Diabltica/Desktopia/documentation/global-architecture.png

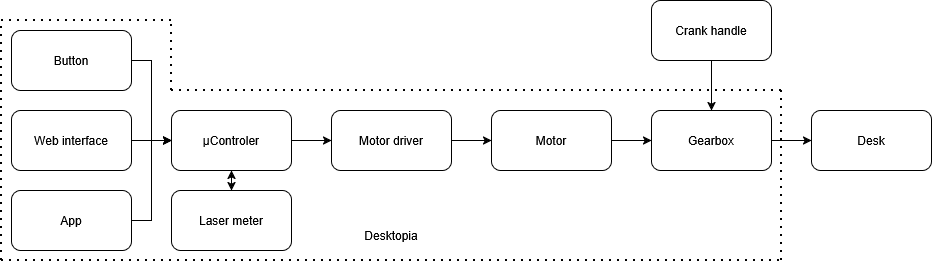
documentation/global-architecture.png
