Diabltica/Desktopia/mechanical/docs/clip_sample4_drawing.png

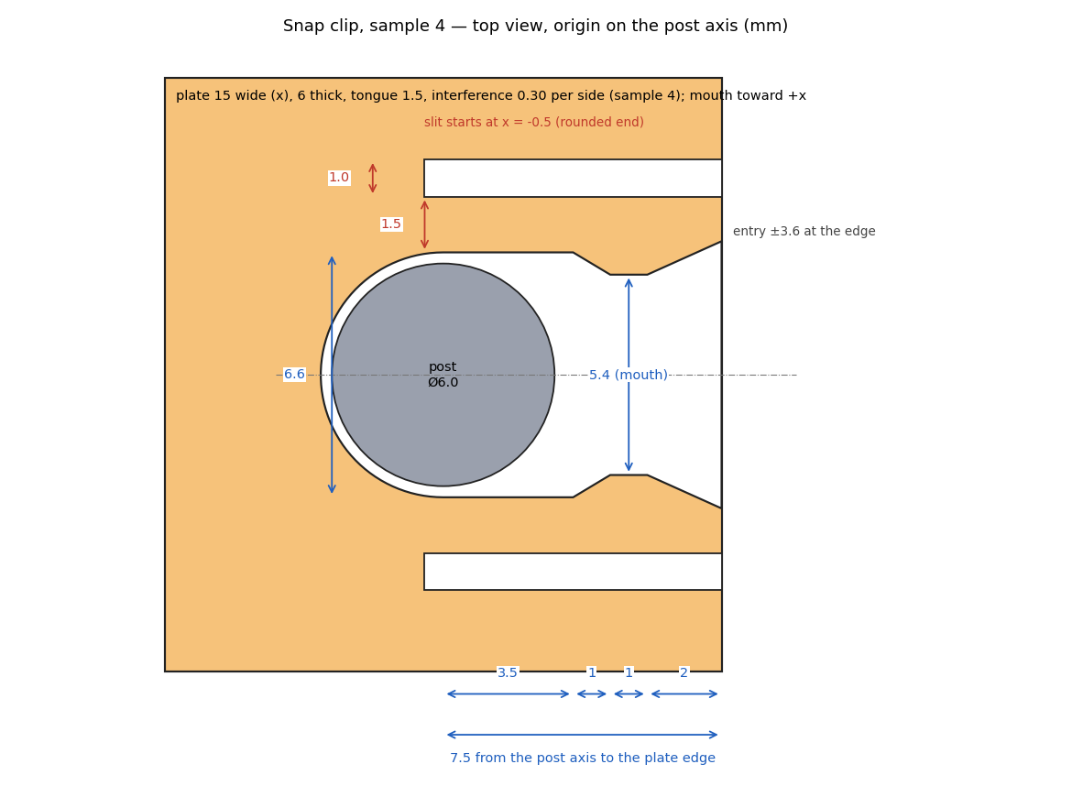
mechanical/docs/clip_sample4_drawing.png
