Diabltica/Desktopia/mechanical/step/assembly_coupler_on_hub_b.step

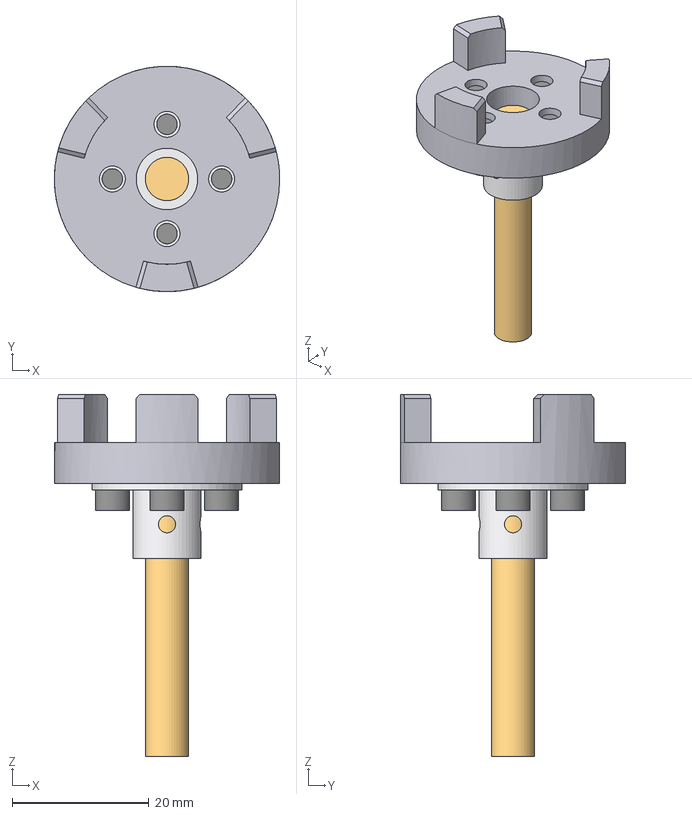
[picture p16: CAD file, 2026-11-08]
mechanical/step/assembly_coupler_on_hub_b.step
33.0 x 33.0 x 53.0 mm
hub_b_flange_side
flange_coupler
screws_M3x6
desk_shaft_6.35
