Diabltica/Desktopia/mechanical/step/assembly_coupler.step

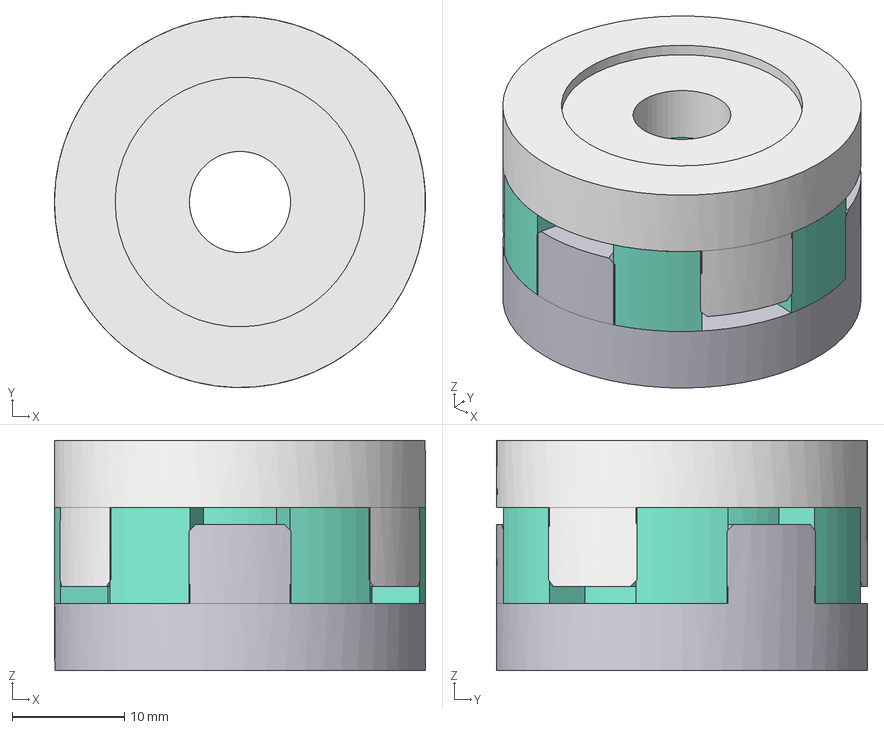
[picture p17: CAD file, 2026-11-08]
mechanical/step/assembly_coupler.step
33.0 x 33.0 x 20.5 mm
hub_b_flange_side
spider_tpu
hub_a_drill_side
