Diabltica/Desktopia/mechanical/step/assembly_check.step

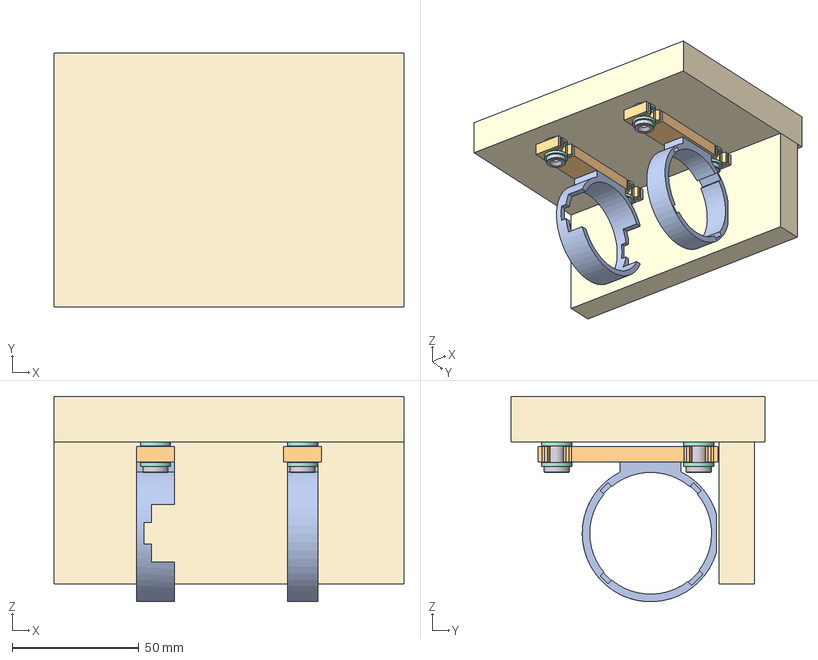
[picture p18: CAD file, 2026-11-08]
mechanical/step/assembly_check.step
138.0 x 100.0 x 81.0 mm
plank
vertical_wood
ring_support_motor_mount
clip_plate_motor_mount
plot_motor_mount_-37
cushion_top_motor_mount_-37
cushion_bottom_motor_mount_-37
plot_motor_mount_+19
cushion_top_motor_mount_+19
cushion_bottom_motor_mount_+19
ring_support_front_mount
clip_plate_front_mount
plot_front_mount_-37
cushion_top_front_mount_-37
cushion_bottom_front_mount_-37
plot_front_mount_+19
cushion_top_front_mount_+19
cushion_bottom_front_mount_+19
