Diabltica/Desktopia/hardware/kicad_library/pcb/EASYEDA_MODELS/SOP-8_L4.9-W3.9-P1.27-LS6.0-BL-1.step

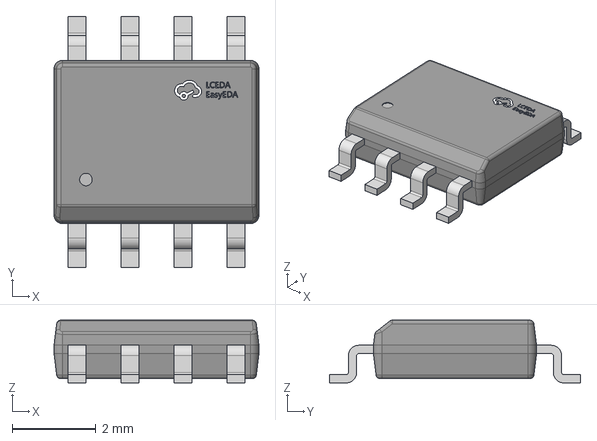
[picture p19: CAD file, 2026-08-25]
hardware/kicad_library/pcb/EASYEDA_MODELS/SOP-8_L4.9-W3.9-P1.27-LS6.0-BL-1.step
4.90 x 6.00 x 1.50 mm
