Diabltica/Desktopia/mechanical/stl/ring_support_front_mount_print.stl

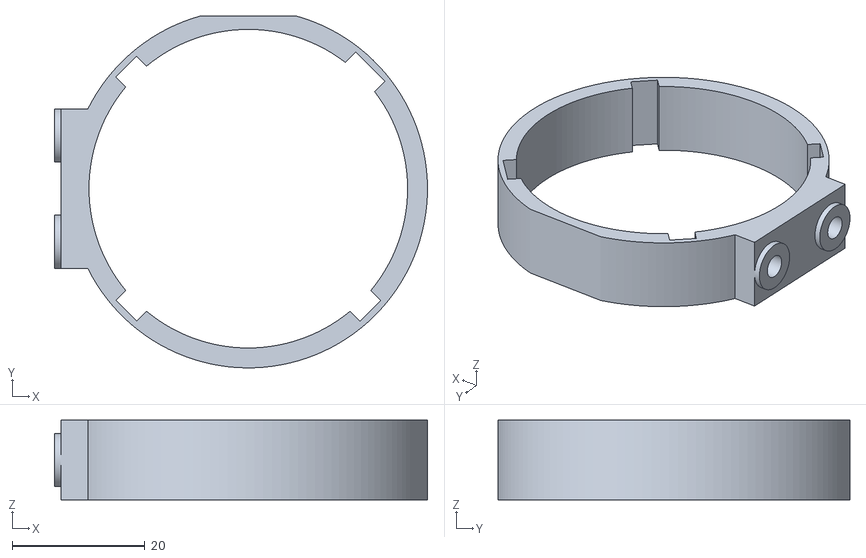
[picture p20: CAD file, 2026-11-08]
mechanical/stl/ring_support_front_mount_print.stl
56.2 x 53.0 x 12.0
