Diabltica/Desktopia/mechanical/solidworks/drillAdapterV4.SLDPRT

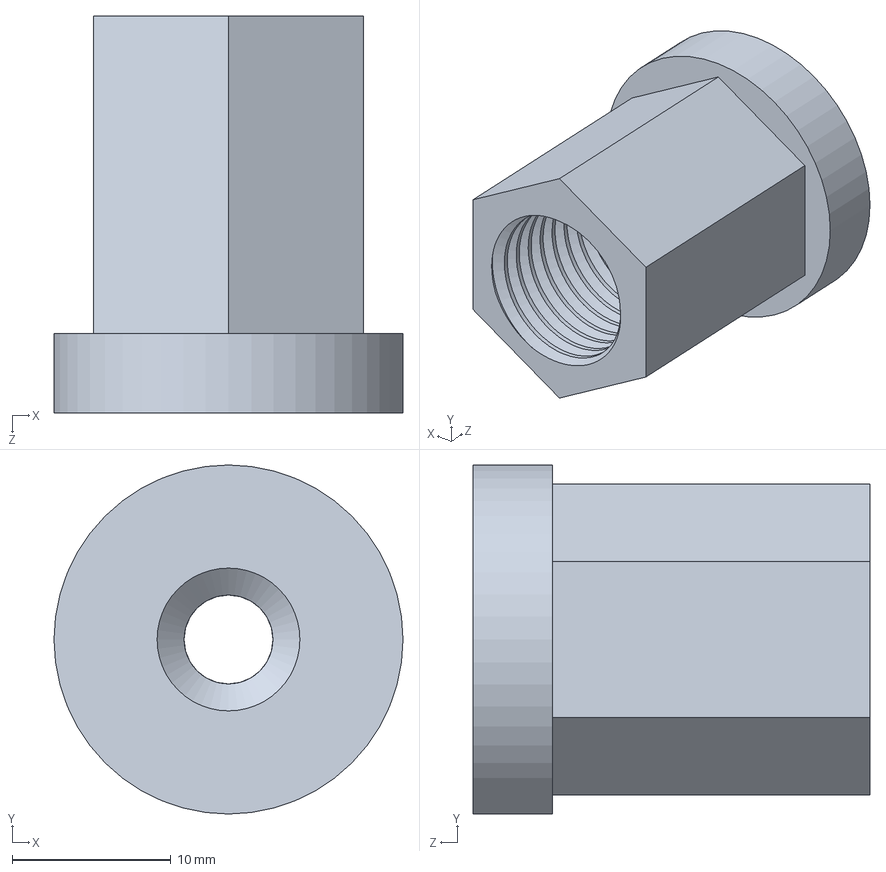
[picture p21: CAD file, 2026-11-03]
mechanical/solidworks/drillAdapterV4.SLDPRT
22.0 x 22.0 x 25.0 mm
