Diabltica/Desktopia/mechanical/stl/clip_plates_x2.stl

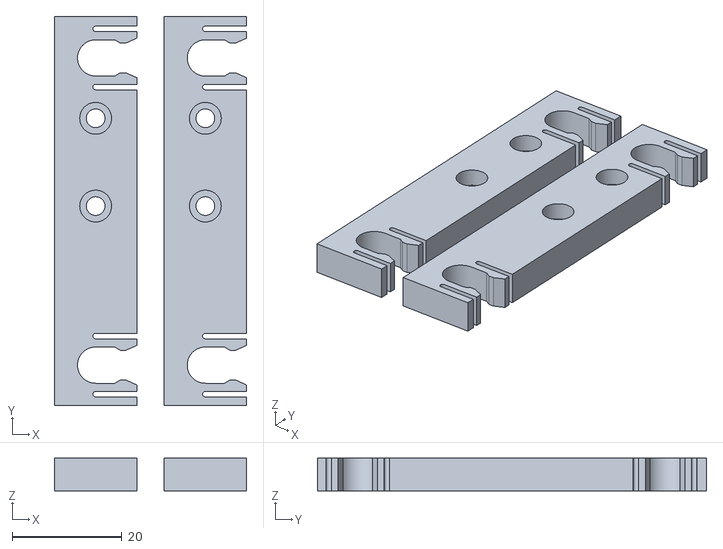
[picture p22: CAD file, 2026-11-08]
mechanical/stl/clip_plates_x2.stl
35.0 x 71.0 x 6.00
