Diabltica/Desktopia/mechanical/step/drill_jig.step

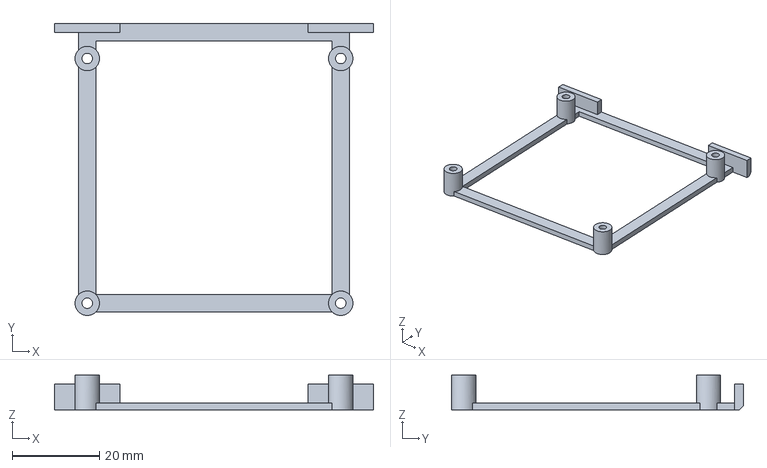
[picture p23: CAD file, 2026-11-08]
mechanical/step/drill_jig.step
73.0 x 66.8 x 8.00 mm
