Diabltica/Desktopia/mechanical/stl/ring_support_motor_mount_print.stl

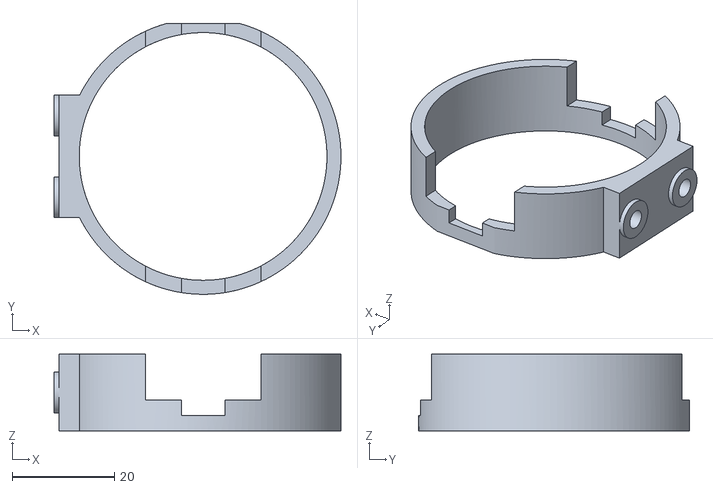
[picture p24: CAD file, 2026-11-08]
mechanical/stl/ring_support_motor_mount_print.stl
56.2 x 53.0 x 15.0
