Diabltica/Desktopia/mechanical/stl/cushions_x8.stl

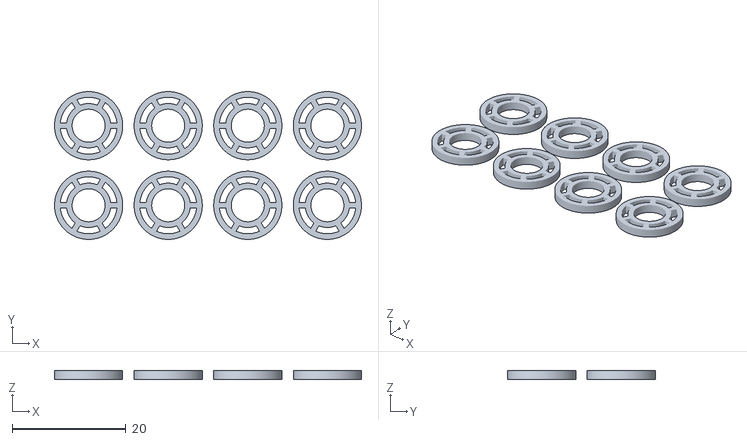
[picture p25: CAD file, 2026-11-02]
mechanical/stl/cushions_x8.stl
54.0 x 26.0 x 1.50
