Diabltica/Desktopia/mechanical/step/clip_plate_mirrored.step

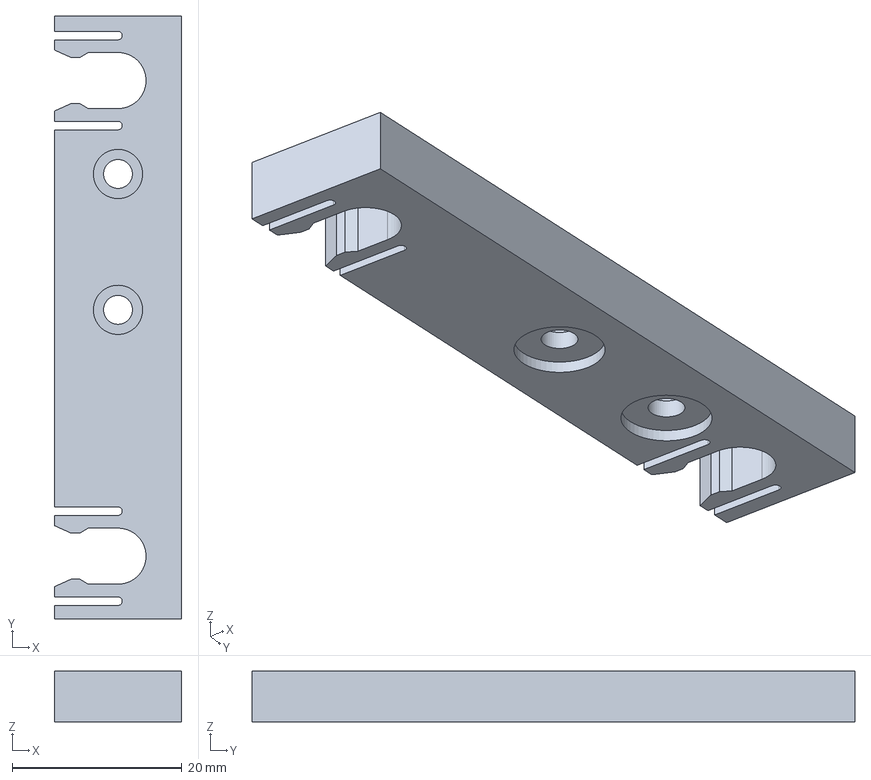
[picture p26: CAD file, 2026-11-08]
mechanical/step/clip_plate_mirrored.step
15.0 x 71.0 x 6.00 mm
