Diabltica/Desktopia/mechanical/stl/plots_x4.stl

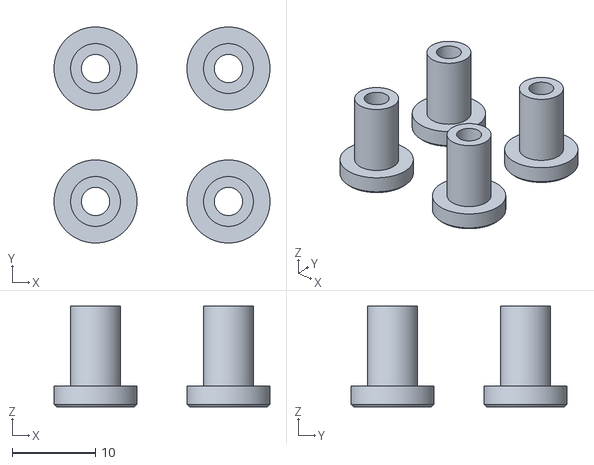
[picture p27: CAD file, 2026-11-02]
mechanical/stl/plots_x4.stl
26.0 x 26.0 x 12.1
