Diabltica/Desktopia/mechanical/step/hub_b_flange_side.step

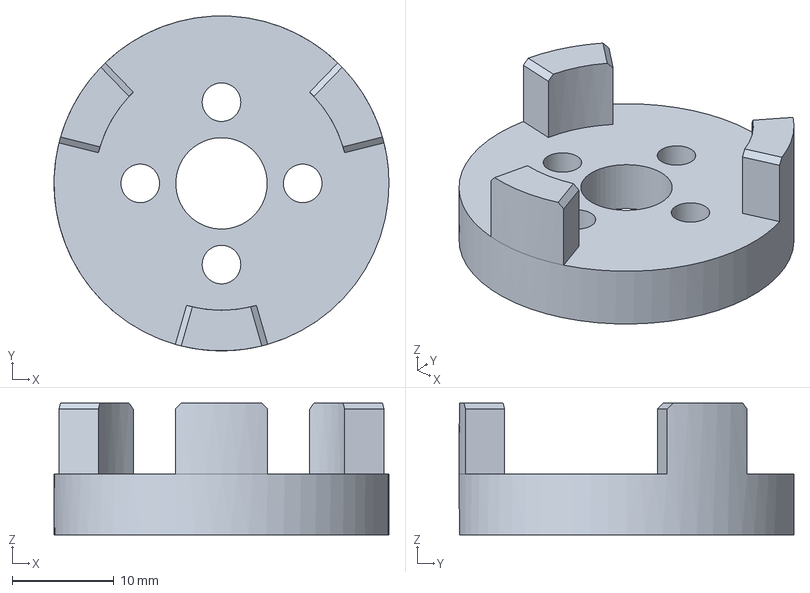
[picture p28: CAD file, 2026-11-08]
mechanical/step/hub_b_flange_side.step
33.0 x 33.0 x 13.0 mm
