Diabltica/Desktopia/mechanical/step/clip_cut_tool.step

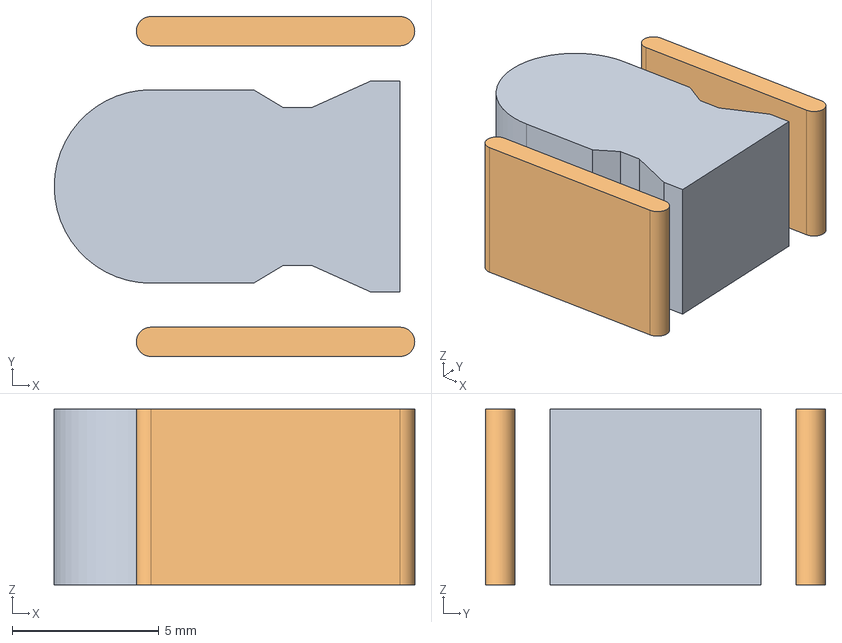
[picture p29: CAD file, 2026-11-02]
mechanical/step/clip_cut_tool.step
12.3 x 11.6 x 6.00 mm
