Diabltica/Desktopia/mechanical/step/clip_sample4_profile.dxf

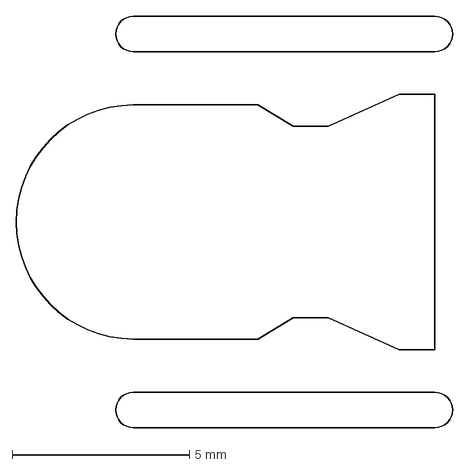
[picture p30: CAD file, 2026-11-02]
mechanical/step/clip_sample4_profile.dxf
12.3 x 11.6 mm
