Diabltica/Desktopia/mechanical/step/cushion_solid.step

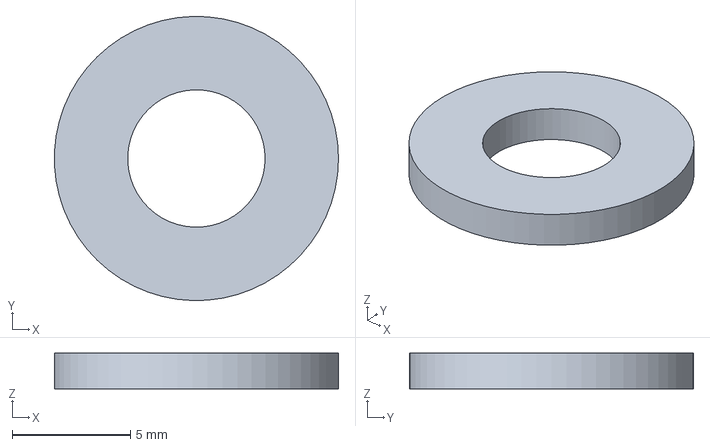
[picture p31: CAD file, 2026-11-02]
mechanical/step/cushion_solid.step
12.0 x 12.0 x 1.50 mm
