Diabltica/Desktopia/mechanical/step/cushion_wheel.step

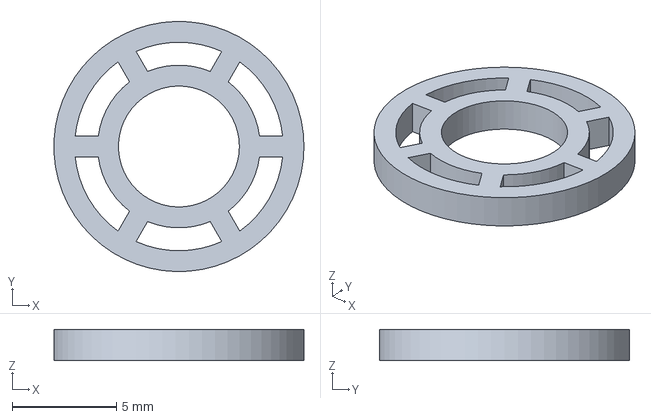
[picture p32: CAD file, 2026-11-02]
mechanical/step/cushion_wheel.step
12.0 x 12.0 x 1.50 mm
