Diabltica/Desktopia/mechanical/step/flange_coupler_6.35mm.step

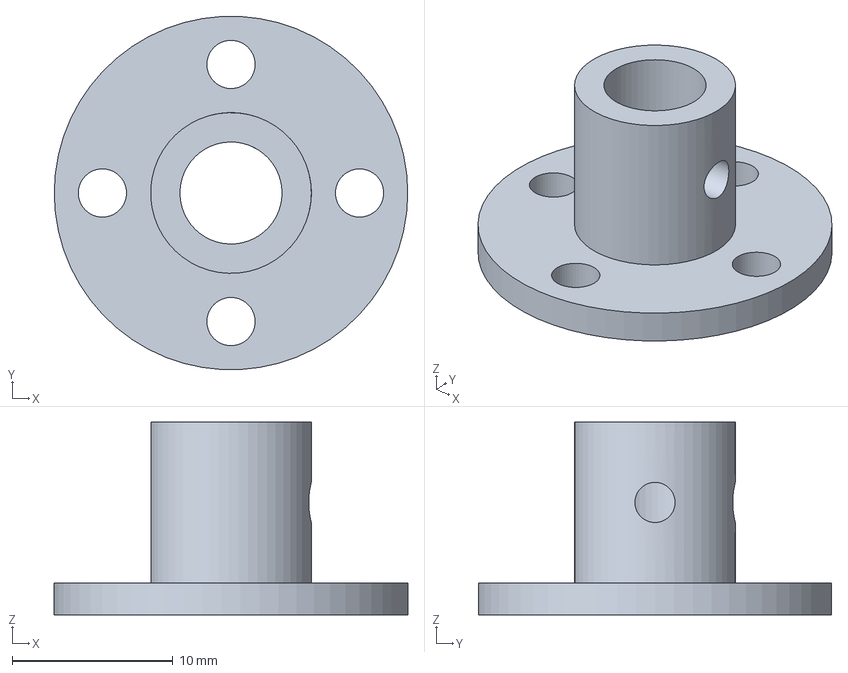
[picture p33: CAD file, 2026-11-02]
mechanical/step/flange_coupler_6.35mm.step
22.0 x 22.0 x 12.0 mm
