Diabltica/Desktopia/mechanical/step/plot.step

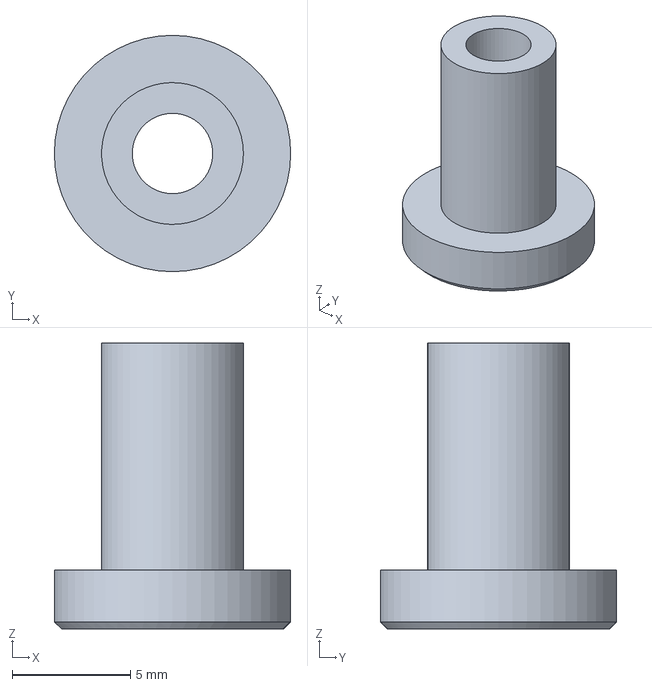
[picture p34: CAD file, 2026-11-02]
mechanical/step/plot.step
10.0 x 10.0 x 12.1 mm
