Diabltica/Desktopia/mechanical/step/spider_tpu.step

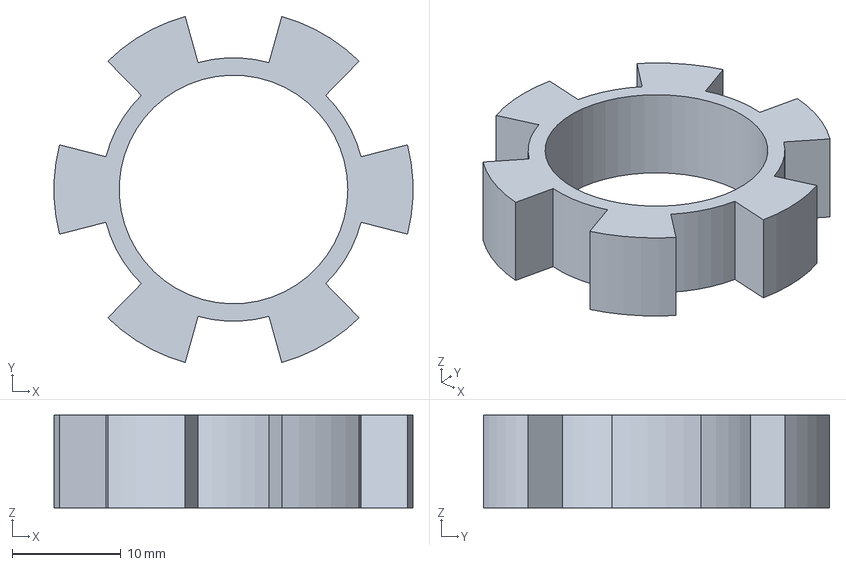
[picture p35: CAD file, 2026-11-02]
mechanical/step/spider_tpu.step
33.0 x 31.8 x 8.50 mm
