Diabltica/Desktopia/mechanical/solidworks/DrillAdapter+hub.SLDASM

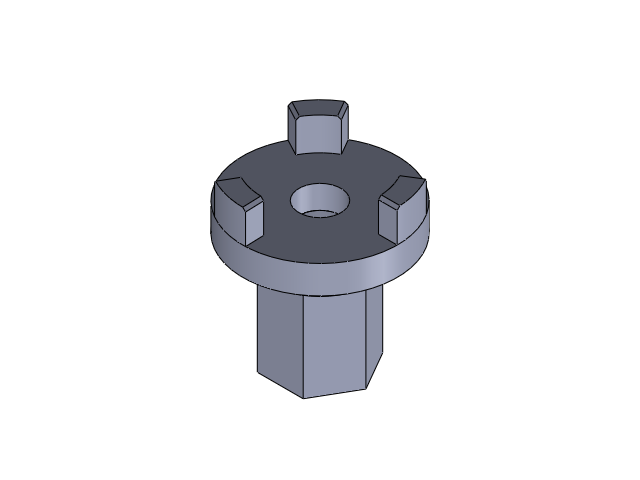
[picture p36: CAD file, 2026-11-03]
mechanical/solidworks/DrillAdapter+hub.SLDASM
drillAdapterV4
hub_a_drill_side
