Diabltica/Desktopia/(list of files, cad)

Other CAD files:
mechanical/step/ring_support_front_mount_desk_frame.step
mechanical/step/clip_plate.step
mechanical/step/ring_support_motor_mount_desk_frame.step
mechanical/step/hub_a_drill_side.step
mechanical/solidworks/DrillAdapter+hub.STL
mechanical/solidworks/drillAdapter.SLDPRT
mechanical/solidworks/drillAdapter.STL
mechanical/solidworks/hub_a_drill_side.SLDPRT
mechanical/stl/clip_cut_tool.stl
mechanical/stl/clip_plate.stl
mechanical/stl/clip_plate_mirrored.stl
mechanical/stl/cushion_solid.stl
mechanical/stl/cushion_wheel.stl
mechanical/stl/drill_jig.stl
mechanical/stl/hub_a_drill_side.stl
mechanical/stl/hub_b_flange_side.stl
mechanical/stl/plot.stl
mechanical/stl/ring_support_front_mount_desk_frame.stl
mechanical/stl/ring_support_motor_mount_desk_frame.stl
mechanical/stl/spider_tpu.stl
