Diabltica/Desktopia/mechanical/docs/img/step_1_inserts.png

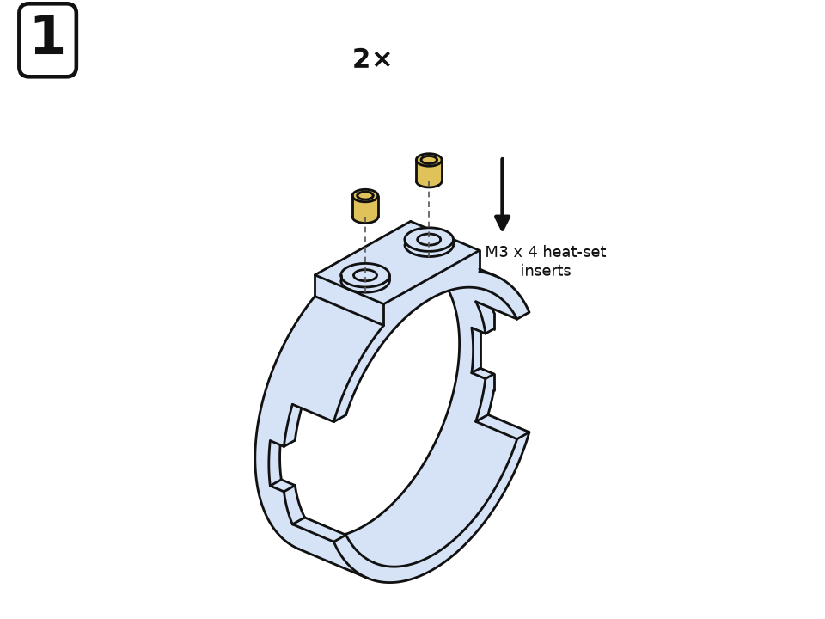
mechanical/docs/img/step_1_inserts.png
