Diabltica/Desktopia/mechanical/docs/img/step_5_slide_in.png

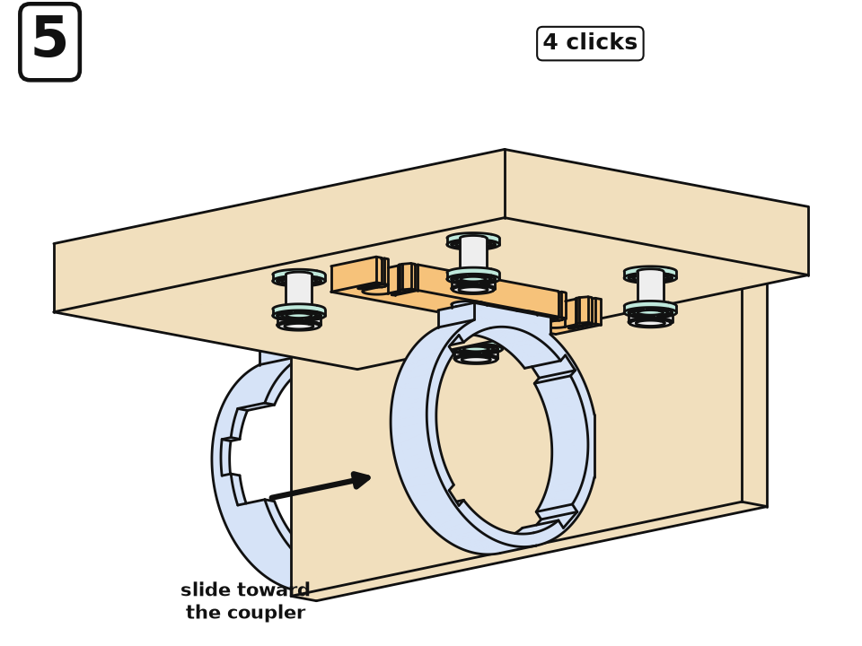
mechanical/docs/img/step_5_slide_in.png
