Diabltica/Desktopia/hardware/desktopia/desktopia.kicad_pcb

## KiCad design hardware/desktopia/desktopia.kicad_pcb (2026-11-11)

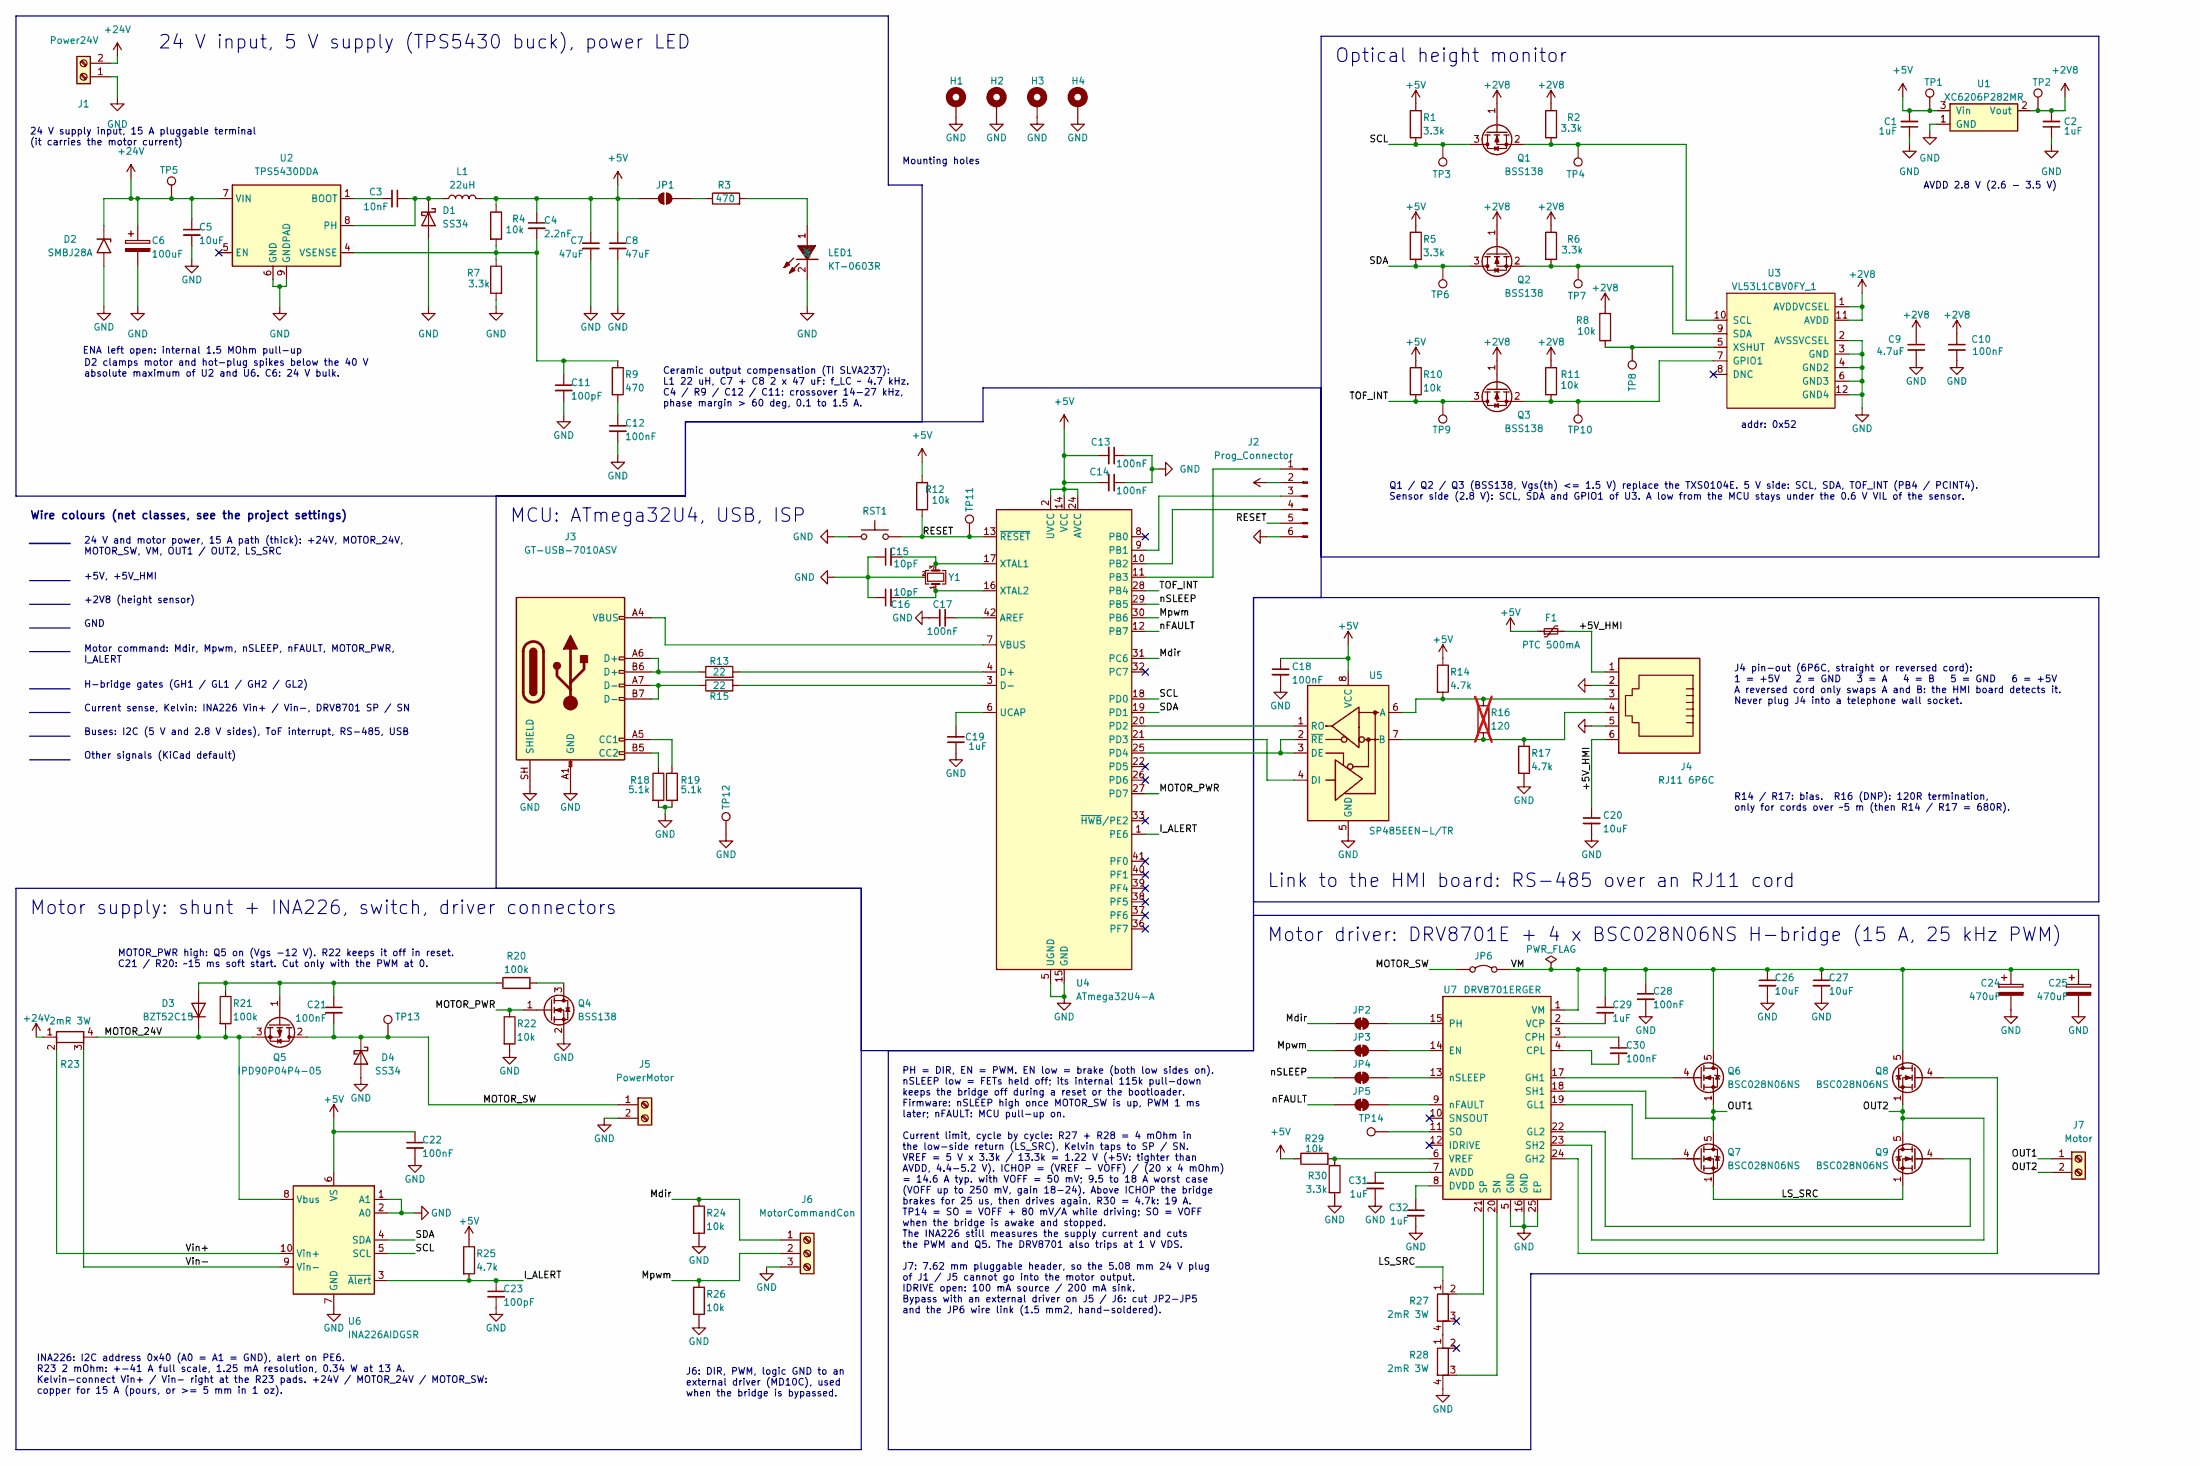
[picture p64: schematic desktopia.kicad_sch, Desktopia - motherboard]

Parts:
C1, C2, C19, C29, C31, C32: 1uF; C_0402_1005Metric; jlcpcb PartNumber C52923
C3: 10nF; C_0402_1005Metric; jlcpcb PartNumber C15195
C4: 2.2nF; C_0603_1608Metric; Manufacturer Part 0603B222K500NT; LCSC C1604
C5, C26, C27: 10uF; C_1206_3216Metric; Voltage 50V X5R; LCSC C13585
C6: 100uF; CP_Elec_8x10; Voltage 50V; Manufacturer Part RVT1H101M0810; LCSC C970687
C7, C8: 47uF; C_1206_3216Metric; Voltage 10V X5R; Manufacturer Part CL31A476MPHNNNE; LCSC C96123
C9: 4.7uF; C_0402_1005Metric; jlcpcb PartNumber C23733
C10, C13, C14, C17, C18: 100nF; C_0402_1005Metric; jlcpcb PartNumber C1525
C11, C23: 100pF; C_0402_1005Metric; Manufacturer Part 0402CG101J500NT; LCSC C1546
C12: 100nF; C_0402_1005Metric; Manufacturer Part CL05B104KO5NNNC; LCSC C1525
C15, C16: 10pF; C_0402_1005Metric; jlcpcb PartNumber C32949
C20: 10uF; C_0603_1608Metric; jlcpcb PartNumber C19702
C21, C28, C30: 100nF; C_0402_1005Metric; Voltage 50V X7R; Manufacturer Part CL05B104KB54PNC; LCSC C307331
C22: 100nF; C_0402_1005Metric; LCSC C1525
C24, C25: 470uF; CP_Radial_D10.0mm_P5.00mm; Voltage 50V; Manufacturer Part 50ZLJ470M10X20; LCSC C2902875
D1: SS34; D_SMA; jlcpcb PartNumber C8678
D2: SMBJ28A; D_SMB; Manufacturer Part SMBJ28A; LCSC C19077582
D3: BZT52C15; D_SOD-123; Manufacturer Part BZT52C15; LCSC C19077412
D4: SS34; D_SMA; Manufacturer Part SS34; LCSC C8678
F1: PTC 500mA; Fuse_1206_3216Metric; LCSC C720075
H1, H2, H3, H4: MountingHole_Pad; MountingHole_2.2mm_M2_Pad
J1: Power24V; PluggableHeader_2EDGRC_1x02_P5.08mm_Horizontal; Manufacturer Part KF2EDGRC-5.08-2P; LCSC C441236
J2: Prog_Connector; IDC-Header_2x03_P2.54mm_Vertical
J3: GT-USB-7010ASV; USB_C_Receptacle_G-Switch_GT-USB-7010ASV; Manufacturer Part GT-USB-7010ASV; LCSC C2988369
J4: RJ11 6P6C; RJ12_Amphenol_54601-x06_Horizontal; LCSC C3097716
J5: PowerMotor; PluggableHeader_2EDGRC_1x02_P5.08mm_Horizontal; Manufacturer Part KF2EDGRC-5.08-2P; LCSC C441236
J6: MotorCommandCon; PluggableHeader_15EDGRC_1x03_P3.81mm_Horizontal; Manufacturer Part WJ15EDGRC-3.81-03P-14-00A; LCSC C8406
J7: Motor; PluggableHeader_2EDGRC_1x02_P7.62mm_Horizontal; Manufacturer Part KF2EDGRC-7.62-2P; LCSC C441246
JP1: SolderJumper_2_Open; SolderJumper-2_P1.3mm_Open_TrianglePad1.0x1.5mm
JP2, JP3, JP4, JP5: SolderJumper_2_Bridged; SolderJumper-2_P1.3mm_Bridged_RoundedPad1.0x1.5mm
JP6: 1.5 mm2 wire; SolderWire-1.5sqmm_1x02_P6mm_D1.7mm_OD3mm
L1: 22uH; L_Sunlord_SWPA6045S; Manufacturer Part SWPA6045S220MT; jlcpcb PartNumber C83454
LED1: KT-0603R; Manufacturer Part KT-0603R; LCSC C2286
Q1, Q2, Q3, Q4: BSS138; SOT-23; Manufacturer Part BSS138; LCSC C7420339
Q5: IPD90P04P4-05; TO-252-2; Manufacturer Part IPD90P04P405; LCSC C536914
Q6, Q7, Q8, Q9: BSC028N06NS; TDSON-8-1; Manufacturer Part BSC028N06NSATMA1; LCSC C148250
R1, R2, R5, R6, R7, R30: 3.3k; R_0402_1005Metric; jlcpcb PartNumber C25890
R3: 470; R_0402_1005Metric; jlcpcb PartNumber C25117
R4, R8, R11, R12: 10k; R_0402_1005Metric; jlcpcb PartNumber C25744
R9: 470; R_0402_1005Metric; Manufacturer Part 0402WGF4700TCE; LCSC C25117
R10, R22, R24, R26, R29: 10k; R_0402_1005Metric; Manufacturer Part 0402WGF1002TCE; LCSC C25744
R13, R15: 22; R_0402_1005Metric; jlcpcb PartNumber C25092
R14, R17: 4.7k; R_0402_1005Metric; jlcpcb PartNumber C25900
R16: 120; R_0402_1005Metric; jlcpcb PartNumber C25079; not fitted
R18, R19: 5.1k; R_0402_1005Metric; jlcpcb PartNumber C25905
R20, R21: 100k; R_0402_1005Metric; Manufacturer Part 0402WGF1003TCE; LCSC C25741
R23, R27, R28: 2mR 3W; R_2512_CurrentSensing_opti; LCSC C154685
R25: 4.7k; R_0402_1005Metric; LCSC C25900
RST1: TS-1088-AR02016; SW_SPST_TS-1088-xR020; LCSC C720477
TP1, TP2, TP3, TP4, TP5, TP6, TP7, TP8, TP9, TP10, TP11, TP12, TP13, TP14: TestPoint; TestPoint_Pad_D1.0mm
U1: XC6206P282MR; SOT-23-3; Manufacturer Part XC6206P282MR; LCSC C347374
U2: TPS5430DDA; TI_SO-PowerPAD-8_ThermalVias; jlcpcb PartNumber C9864
U3: VL53L1CBV0FY_1; Manufacturer Part VL53L1CBV0FY/1; LCSC C2970716
U4: ATmega32U4-A; TQFP-44_10x10mm_P0.8mm; LCSC C44854
U5: SP485EEN-L/TR; SOIC-8_3.9x4.9mm_P1.27mm; LCSC C6855
U6: INA226AIDGSR; TSSOP-10_3x3mm_P0.5mm; LCSC C49851
U7: DRV8701ERGER; Texas_RGE0024H_VQFN-24-1EP_4x4mm_P0.5mm_EP2.7x2.7mm_Thermal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; Manufacturer Part DRV8701ERGER; LCSC C90964
Y1: X322516MLB4SI; Crystal_SMD_3225-4Pin_3.2x2.5mm; jlcpcb PartNumber C13738

Connections:
+2V8: C2.2, C9.1, C10.1, Q1.1 (G), Q2.1 (G), Q3.1 (G), R2.1, R6.1, R8.1, R11.1, TP2.1 (1_1), U1.2 (Vout), U3.1 (AVDDVCSEL), U3.11 (AVDD)
+5V: C1.2, C4.1, C7.1, C8.1, C13.2, C14.2, C18.1, C22.1, F1.1, J2.2, JP1.1 (A), L1.2, R1.1, R4.1, R5.1, R10.1, R12.1, R14.1, R25.1, R29.1, TP1.1 (1_1), U1.3 (Vin), U4.2 (UVCC), U4.14 (VCC), U4.24 (AVCC), U4.34 (VCC), U4.44 (AVCC), U5.8 (VCC), U6.6 (VS)
+24V: C5.1, C6.1, D2.1 (A1), J1.2, R23.1, TP5.1 (1_1), U2.7 (VIN)
/+5V_HMI: C20.1, F1.2, J4.1, J4.6
/I_ALERT: C23.1, R25.2, U4.1 (PE6), U6.3 (~Alert)
/LS_SRC: Q7.1 (S), Q7.2 (S), Q7.3 (S), Q9.1 (S), Q9.2 (S), Q9.3 (S), R27.1
/MOTOR_24V: D3.1 (K), Q5.3 (S), R21.2, R23.4, U6.8 (Vbus)
/MOTOR_PWR: Q4.1 (G), R22.1, U4.27 (PD7)
/MOTOR_SW: C21.2, D4.1 (K), J5.1, JP6.1 (A), Q5.2 (D), TP13.1 (1_1)
/Mdir: J6.1, JP2.1 (A), R24.1, U4.31 (PC6)
/Mpwm: J6.2, JP3.1 (A), R26.1, U4.30 (PB6)
/OUT1: J7.1, Q6.1 (S), Q6.2 (S), Q6.3 (S), Q7.5 (D), U7.18 (SH1)
/OUT2: J7.2, Q8.1 (S), Q8.2 (S), Q8.3 (S), Q9.5 (D), U7.23 (SH2)
/RESET: J2.5, R12.2, RST1.2, TP11.1 (1_1), U4.13 (~RESET)
/SCL: Q1.3 (D), R1.2, TP3.1 (1_1), U4.18 (PD0), U6.5 (SCL)
/SDA: Q2.3 (D), R5.2, TP6.1 (1_1), U4.19 (PD1), U6.4 (SDA)
/TOF_INT: Q3.3 (D), R10.2, TP9.1 (1_1), U4.28 (PB4)
/Vin+: R23.2, U6.10 (Vin+)
/Vin-: R23.3, U6.9 (Vin-)
/nFAULT: JP5.1 (A), U4.12 (PB7)
/nSLEEP: JP4.1 (A), U4.29 (PB5)
GND: C1.1, C2.1, C5.2, C6.2, C7.2, C8.2, C9.2, C10.2, C11.2, C12.2, C13.1, C14.1, C15.1, C16.1, C17.1, C18.2, C19.1, C20.2, C22.2, C23.2, C24.2, C25.2, C26.2, C27.2, C28.2, C31.2, C32.2, D1.2 (A), D2.2 (A2), D4.2 (A), H1.1 (1_1), H2.1 (1_1), H3.1 (1_1), H4.1, J1.1, J2.6, J3.A1 (GND), J3.A12 (GND), J3.B1 (GND), J3.B12 (GND), J3.SH (SHIELD), J4.2, J4.5, J5.2, J6.3, LED1.2 (K), Q4.2 (S), R7.2, R17.2, R18.2, R19.2, R22.2, R24.2, R26.2, R28.4, R30.2, RST1.1, TP12.1 (1_1), U1.1 (GND), U2.6 (GND), U2.9 (GNDPAD), U3.2 (AVSSVCSEL), U3.3 (GND), U3.4 (GND2), U3.6 (GND3), U3.12 (GND4), U4.5 (UGND), U4.15 (GND), U4.23 (GND), U4.35 (GND), U4.43 (GND), U5.5 (GND), U6.1 (A1), U6.2 (A0), U6.7 (GND), U7.5 (GND), U7.16 (GND), U7.25 (EP), Y1.2 (G), Y1.4 (G)
unnamed: C12.1, R9.2
unnamed: C3.1, D1.1 (K), L1.1, U2.8 (PH)
unnamed: C21.1, D3.2 (A), Q5.1 (G), R20.1, R21.1
unnamed: J2.1, U4.11 (PB3)
unnamed: J2.3, U4.9 (PB1)
unnamed: J2.4, U4.10 (PB2)
unnamed: J3.A5 (CC1), R19.1
unnamed: J3.B5 (CC2), R18.1
unnamed: J3.A6 (D+), J3.B6 (D+), R13.1
unnamed: J3.A7 (D-), J3.B7 (D-), R15.1
unnamed: JP1.2 (B), R3.1
unnamed: JP2.2 (B), U7.15 (PH)
unnamed: JP3.2 (B), U7.14 (EN)
unnamed: JP4.2 (B), U7.13 (nSLEEP)
unnamed: JP5.2 (B), U7.9 (nFAULT)
unnamed: C24.1, C25.1, C26.1, C27.1, C28.1, C29.1, JP6.2 (B), Q6.5 (D), Q8.5 (D), U7.1 (VM)
unnamed: LED1.1 (A), R3.2
unnamed: Q1.2 (S), R2.2, TP4.1 (1_1), U3.10 (SCL)
unnamed: Q2.2 (S), R6.2, TP7.1 (1_1), U3.9 (SDA)
unnamed: Q3.2 (S), R11.2, TP10.1 (1_1), U3.7 (GPIO1)
unnamed: Q4.3 (D), R20.2
unnamed: Q6.4 (G), U7.17 (GH1)
unnamed: Q7.4 (G), U7.19 (GL1)
unnamed: Q8.4 (G), U7.24 (GH2)
unnamed: Q9.4 (G), U7.22 (GL2)
unnamed: R27.4, R28.1
unnamed: C3.2, U2.1 (BOOT)
unnamed: C4.2, C11.1, R4.2, R7.1, R9.1, U2.4 (VSENSE)
unnamed: R8.2, TP8.1 (1_1), U3.5 (XSHUT)
unnamed: C17.2, U4.42 (AREF)
unnamed: R13.2, U4.4 (D+)
unnamed: R15.2, U4.3 (D-)
unnamed: U4.20 (PD2), U5.1 (RO)
unnamed: U4.21 (PD3), U5.4 (DI)
unnamed: U4.25 (PD4), U5.2 (~RE), U5.3 (DE)
unnamed: C19.2, U4.6 (UCAP)
unnamed: J3.A4 (VBUS), J3.A9 (VBUS), J3.B4 (VBUS), J3.B9 (VBUS), U4.7 (VBUS)
unnamed: C15.2, U4.17 (XTAL1), Y1.3
unnamed: C16.2, U4.16 (XTAL2), Y1.1
unnamed: J4.3, R14.2, R16.1, U5.6 (A)
unnamed: J4.4, R16.2, R17.1, U5.7 (B)
unnamed: C31.1, U7.7 (AVDD)
unnamed: C30.1, U7.3 (CPH)
unnamed: C30.2, U7.4 (CPL)
unnamed: C32.1, U7.8 (DVDD)
unnamed: R28.3, U7.20 (SN)
unnamed: TP14.1 (1_1), U7.11 (SO)
unnamed: R27.2, U7.21 (SP)
unnamed: C29.2, U7.2 (VCP)
unnamed: R29.2, R30.1, U7.6 (VREF)

Notes on the sheet:
J4 pin-out (6P6C, straight or reversed cord): 1 = +5V 2 = GND 3 = A 4 = B 5 = GND 6 = +5V A reversed cord only swaps A and B: the HMI board detects it. Never plug J4 into a telephone wall socket.
+2V8 (height sensor)
MCU: ATmega32U4, USB, ISP
24 V supply input, 15 A pluggable terminal (it carries the motor current)
Link to the HMI board: RS-485 over an RJ11 cord
J6: DIR, PWM, logic GND to an external driver (MD10C), used when the bridge is bypassed.
Current sense, Kelvin: INA226 Vin+ / Vin-, DRV8701 SP / SN
addr: 0x52
Q1 / Q2 / Q3 (BSS138, Vgs(th) <= 1.5 V) replace the TXS0104E. 5 V side: SCL, SDA, TOF_INT (PB4 / PCINT4). Sensor side (2.8 V): SCL, SDA and GPIO1 of U3. A low from the MCU stays under the 0.6 V VIL of the sensor.
Mounting holes
Motor supply: shunt + INA226, switch, driver connectors
H-bridge gates (GH1 / GL1 / GH2 / GL2)
24 V and motor power, 15 A path (thick): +24V, MOTOR_24V, MOTOR_SW, VM, OUT1 / OUT2, LS_SRC
Motor command: Mdir, Mpwm, nSLEEP, nFAULT, MOTOR_PWR, I_ALERT
Motor driver: DRV8701E + 4 x BSC028N06NS H-bridge (15 A, 25 kHz PWM)
AVDD 2.8 V (2.6 - 3.5 V)
D2 clamps motor and hot-plug spikes below the 40 V absolute maximum of U2 and U6. C6: 24 V bulk.
+5V, +5V_HMI
MOTOR_PWR high: Q5 on (Vgs -12 V). R22 keeps it off in reset. C21 / R20: ~15 ms soft start. Cut only with the PWM at 0.
INA226: I2C address 0x40 (A0 = A1 = GND), alert on PE6. R23 2 mOhm: +-41 A full scale, 1.25 mA resolution, 0.34 W at 13 A. Kelvin-connect Vin+ / Vin- right at the R23 pads. +24V / MOTOR_24V / MOTOR_SW: copper for 15 A (pours, or >= 5 mm in 1 oz).
Other signals (KiCad default)
Ceramic output compensation (TI SLVA237): L1 22 uH, C7 + C8 2 x 47 uF: f_LC ~ 4.7 kHz. C4 / R9 / C12 / C11: crossover 14-27 kHz, phase margin > 60 deg, 0.1 to 1.5 A.
R14 / R17: bias. R16 (DNP): 120R termination, only for cords over ~5 m (then R14 / R17 = 680R).
ENA left open: internal 1.5 MOhm pull-up
GND
PH = DIR, EN = PWM. EN low = brake (both low sides on). nSLEEP low = FETs held off; its internal 115k pull-down keeps the bridge off during a reset or the bootloader. Firmware: nSLEEP high once MOTOR_SW is up, PWM 1 ms later; nFAULT: MCU pull-up on. Current limit, cycle by cycle: R27 + R28 = 4 mOhm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
24 V input, 5 V supply (TPS5430 buck), power LED
Optical height monitor
Buses: I2C (5 V and 2.8 V sides), ToF interrupt, RS-485, USB
Wire colours (net classes, see the project settings)

Board: 2 copper layers, 117 parts (4 on the bottom side), 72 nets, no tracks yet.
