Diabltica/Desktopia/hardware/desktopia_HMI/desktopia_HMI.kicad_pcb

## KiCad design hardware/desktopia_HMI/desktopia_HMI.kicad_pcb (2026-11-02)

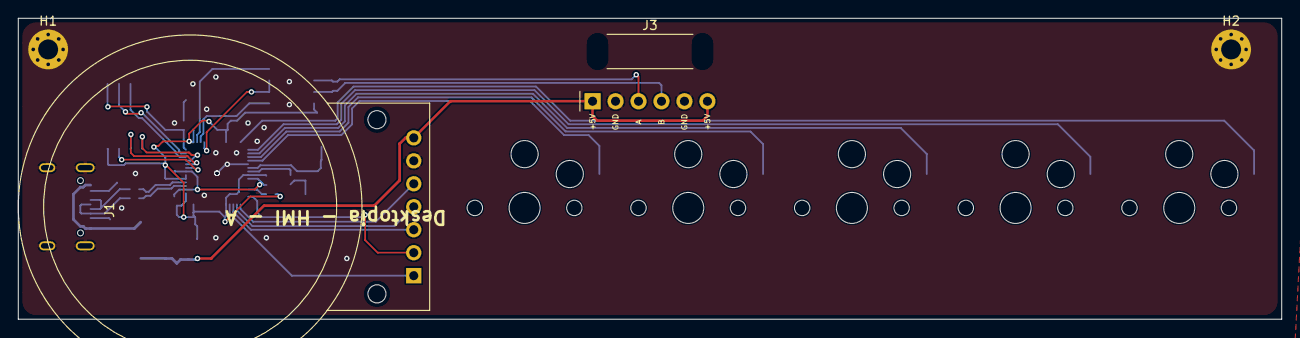
[picture p65: board hardware/desktopia_HMI/desktopia_HMI.kicad_pcb from above]

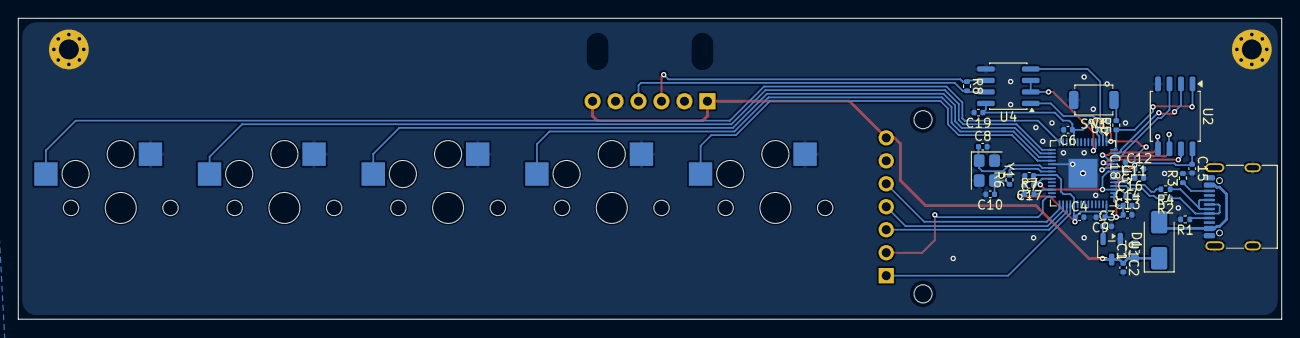
[picture p66: board hardware/desktopia_HMI/desktopia_HMI.kicad_pcb from below]

Board: 2 copper layers, 139.7 x 33.3 mm, 44 parts (35 on the bottom side), 37 nets.

Parts:
C1: 10uF; C_0603_1608Metric
C2, C3, C14, C16: 1uF; C_0402_1005Metric
C4, C5, C6, C7, C9, C11, C12, C13, C15, C17, C18, C19: 100nF; C_0402_1005Metric
C8, C10: 33pF; C_0402_1005Metric
D1: SS14; D_SMA
H1, H2: MountingHole_Pad; MountingHole_2.2mm_M2_Pad_Via
J1: GT-USB-7010ASV; USB_C_Receptacle_G-Switch_GT-USB-7010ASV
J2: LCD_Connector; LCD_round_screen
J3: 6P6C cord, soldered; Cable_6P6C_SolderPads
R1, R3: 5.1k; R_0402_1005Metric
R2, R4: 22; R_0402_1005Metric
R5, R6: 1k; R_0402_1005Metric
R7: 10k; R_0402_1005Metric
R8: 120; R_0402_1005Metric
SW1: TS-1088-AR02016; SW_SPST_TS-1088-xR020
SW2, SW3, SW4, SW5, SW6: SW_Push; PG1350
U1: XC6206P332MR; SOT-23-3
U2: W25Q128JVSIQ; SOIC-8_5.3x5.3mm_P1.27mm
U3: RP2040; QFN-56-1EP_7x7mm_P0.4mm_EP3.2x3.2mm
U4: SP3485EN-L/TR; SOIC-8_3.9x4.9mm_P1.27mm
Y1: 12MHz; Crystal_SMD_3225-4Pin_3.2x2.5mm

Connections:
+1V1: C16.1, C17.1, C18.1, U3.23 (DVDD), U3.45 (VREG_VOUT), U3.50 (DVDD)
+3V3: C3.1, C4.1, C5.1, C6.1, C7.1, C9.1, C11.1, C12.1, C13.1, C14.1, C15.1, C19.1, R7.1, U1.2 (VO), U2.8 (VCC), U3.1 (IOVDD), U3.10 (IOVDD), U3.22 (IOVDD), U3.33 (IOVDD), U3.42 (IOVDD), U3.43 (ADC_AVDD), U3.44 (VREG_VIN), U3.48 (USB_VDD), U3.49 (IOVDD), U4.8 (VCC)
+5V: C1.1, C2.1, D1.1 (K), J2.7, J3.1, J3.6, U1.3 (VI)
/D+: R4.2, U3.47 (USB_DP)
/D-: R2.2, U3.46 (USB_DM)
/data+: J3.4, R8.2, U4.7 (B)
/data-: J3.3, R8.1, U4.6 (A)
GND: C1.2, C2.2, C3.2, C4.2, C5.2, C6.2, C7.2, C8.2, C9.2, C10.2, C11.2, C12.2, C13.2, C14.2, C15.2, C16.2, C17.2, C18.2, C19.2, H1.1 (1_1), H2.1 (1_1), J1.A1 (GND), J1.A12 (GND), J1.B1 (GND), J1.B12 (GND), J1.SH (SHIELD), J2.6, J3.2, J3.5, R1.2, R3.2, SW1.2, SW2.1, SW3.1, SW4.1, SW5.1, SW6.1, U1.1 (GND), U2.4 (GND), U3.19 (TESTEN), U3.57 (GND), U4.5 (GND), Y1.2 (G), Y1.4 (G)
unnamed: C10.1, R6.1, Y1.3
unnamed: D1.2 (A), J1.A4 (VBUS), J1.A9 (VBUS), J1.B4 (VBUS), J1.B9 (VBUS)
unnamed: J1.A5 (CC1), R1.1
unnamed: J1.B5 (CC2), R3.1
unnamed: J1.A6 (D+), J1.B6 (D+), R4.1
unnamed: J1.A7 (D-), J1.B7 (D-), R2.1
unnamed: J2.1, U3.32 (GPIO21)
unnamed: J2.2, U3.28 (GPIO17)
unnamed: J2.3, U3.31 (GPIO20)
unnamed: J2.4, U3.30 (GPIO19)
unnamed: J2.5, U3.29 (GPIO18)
unnamed: R5.2, SW1.1
unnamed: U2.6 (CLK), U3.52 (QSPI_SCLK)
unnamed: U2.5 (DI/IO_{0}), U3.53 (QSPI_SD0)
unnamed: U2.2 (DO/IO_{1}), U3.55 (QSPI_SD1)
unnamed: R5.1, U2.1 (~CS), U3.56 (~QSPI_SS)
unnamed: U2.7 (~HOLD/~RESET/IO_{3}), U3.51 (QSPI_SD3)
unnamed: U2.3 (~WP/IO_{2}), U3.54 (QSPI_SD2)
unnamed: U3.2 (GPIO0), U4.4 (DI)
unnamed: U3.3 (GPIO1), U4.1 (RO)
unnamed: U3.4 (GPIO2), U4.2 (~RE), U4.3 (DE)
unnamed: SW6.2, U3.14 (GPIO11)
unnamed: SW5.2, U3.15 (GPIO12)
unnamed: SW4.2, U3.16 (GPIO13)
unnamed: SW3.2, U3.17 (GPIO14)
unnamed: SW2.2, U3.18 (GPIO15)
unnamed: R7.2, U3.26 (RUN)
unnamed: C8.1, U3.20 (XIN), Y1.1
unnamed: R6.2, U3.21 (XOUT)
