Diabltica/Desktopia/hardware/desktopia.kicad_pcb

## KiCad design hardware/desktopia.kicad_pcb (2026-09-05)

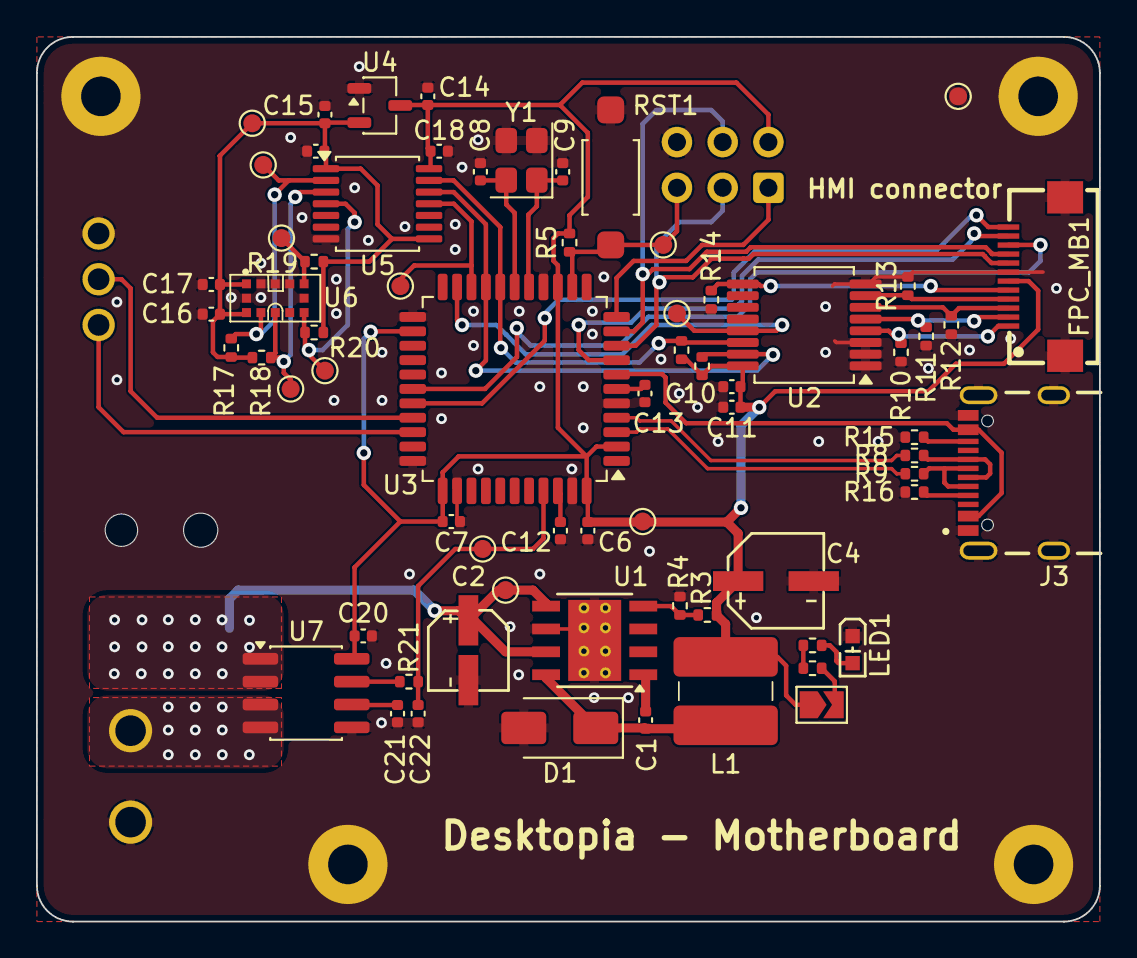
[picture p67: board hardware/desktopia.kicad_pcb from above]

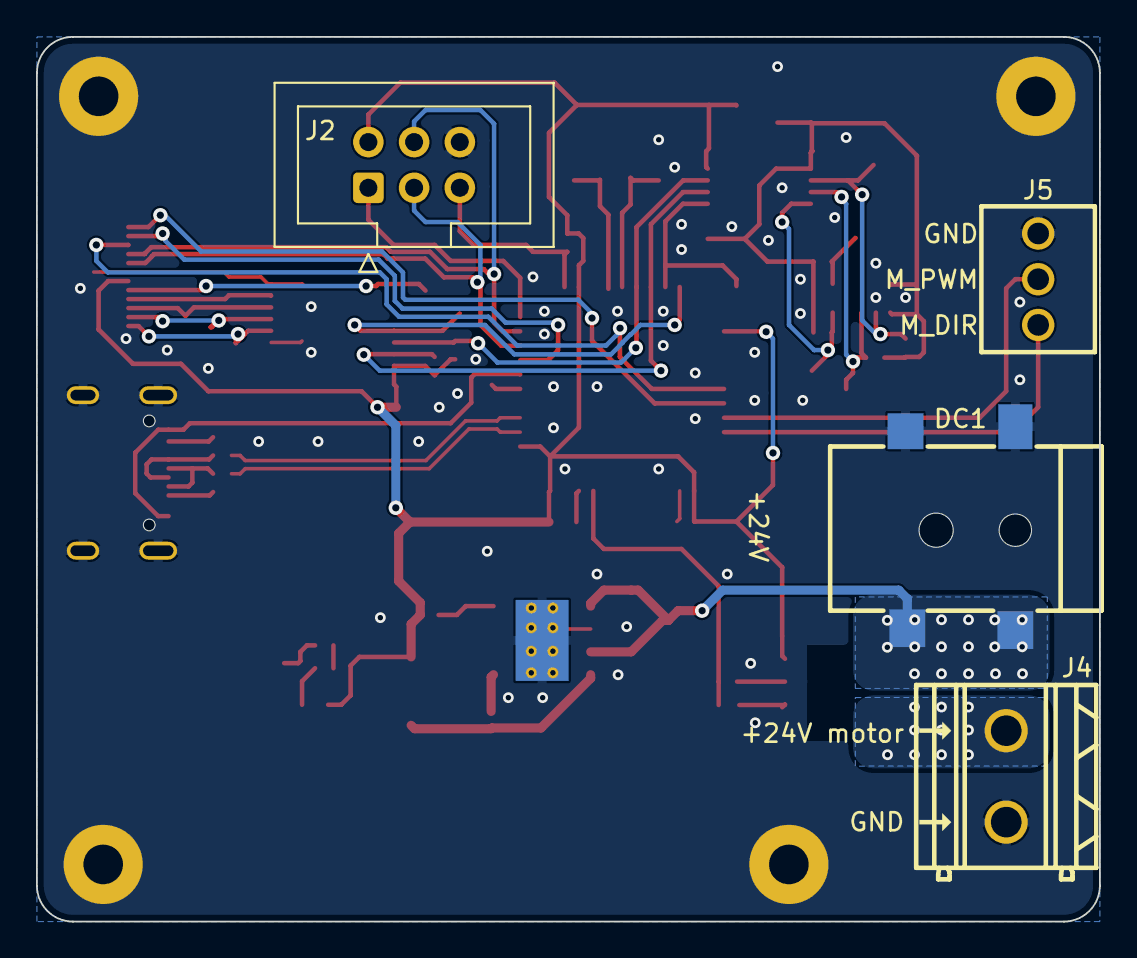
[picture p68: board hardware/desktopia.kicad_pcb from below]

Board: 2 copper layers, 59.1 x 49.1 mm, 76 parts (4 on the bottom side), 47 nets.

Parts:
C1: 10nF; C_0402_1005Metric
C2: 4.7uF; RVT1H4R7M0405_C18221489
C4: 33uF; VE-330M1A0505-TRO
C6, C7, C10, C12, C17, C18, C19, C20: 100nF; C_0402_1005Metric
C8, C9: 10pF; C_0402_1005Metric
C11, C13, C14, C15: 1uF; C_0402_1005Metric
C16: 4.7uF; C_0402_1005Metric
C21: 1nF; C_0402_1005Metric
C22: 100pF; C_0402_1005Metric
D1: SS14; D_SMA
DC1: DC050-2_5-T
FPC_MB1: F2D12U-A1G1-ER
H1, H1#2, H1#3, H2: MountingHole_Pad; MountingHole_2.2mm_M2_Pad
J2: Prog_Connector; IDC-Header_2x03_P2.54mm_Vertical
J3: USB4105GFA; GCT_USB4105GFA
J4: PowerMotor; C508128L-2P0G36
J5: MotorCommandCon; ZX-DG28L-2_54-3P
JP1: SolderJumper_2_Open; SolderJumper-2_P1.3mm_Open_TrianglePad1.0x1.5mm
L1: 84uH; L5.8
LED1: KT-0603R
R1, R2, R21: 100; R_0402_1005Metric
R3, R5, R10, R11, R12, R13, R14, R19, R20: 10k; R_0402_1005Metric
R4, R6, R7, R17, R18: 3.3k; R_0402_1005Metric
R8, R9: 22; R_0402_1005Metric
R15, R16: 5.1k; R_0402_1005Metric
RST1: SW_Push; DTS41
TP1, TP7, TP8, TP9, TP10, TP11, TP14, TP15, TP16, TP17, TP18, TP19: TestPoint; TestPoint_Pad_D1.0mm
U1: TPS5430DDA; TI_SO-PowerPAD-8_ThermalVias
U2: TCA9554DB; SSOP-16_5.3x6.2mm_P0.65mm
U3: ATmega32U4-A; TQFP-44_10x10mm_P0.8mm
U4: XC6206P282MR; SOT-23-3
U5: TXS0104EPW; TSSOP-14_4.4x5mm_P0.65mm
U6: VL53L1CBV0FY_1
U7: CC6905S8-5FB005; SOP-8_3.76x4.96mm_P1.27mm
Y1: X322516MLB4SI; Crystal_SMD_3225-4Pin_3.2x2.5mm

Connections:
+2V8: C15.2, C16.1, C17.1, C19.1, R17.1, R18.1, R19.1, R20.1, TP11.1 (1_1), U4.2 (Vout), U5.1 (V_{CCA}), U5.8 (OE), U6.1 (AVDDVCSEL), U6.11 (AVDD)
+5V: C4.1, C6.2, C7.2, C10.2, C11.2, C14.2, C18.1, C20.2, FPC_MB1.6, J2.2, JP1.1 (A), L1.2, R3.1, R5.1, R6.1, R7.1, TP10.1 (1_1), U2.16 (VDD), U3.2 (UVCC), U3.14 (VCC), U3.24 (AVCC), U3.34 (VCC), U3.44 (AVCC), U4.3 (Vin), U5.14 (V_{CCB}), U7.8 (VCC)
+24V: C2.1, DC1.4, TP1.1 (1_1), U1.5 (EN), U1.7 (VIN), U7.1 (IP+), U7.2 (IP+)
/CS_MBside: FPC_MB1.11, U3.8 (PB0)
/D+: R8.2, U3.4 (D+)
/D-: R9.2, U3.3 (D-)
/DC_MBside: FPC_MB1.10, U3.28 (PB4)
/GPIO1_VL53: TP14.1 (1_1), U3.20 (PD2), U5.11 (B3)
/HMI_~INT: TP8.1 (1_1), U2.13 (~INT), U3.21 (PD3)
/Imotor: C22.2, R21.2, TP19.1 (1_1), U3.41 (PF0)
/MISO: J2.1, U3.11 (PB3)
/MOSI: FPC_MB1.9, J2.4, U3.10 (PB2)
/Mdir: J5.1, U3.31 (PC6)
/Mpwm: J5.2, U3.30 (PB6)
/RESET: J2.5, R5.2, RST1.2, TP7.1 (1_1), U3.13 (~RESET)
/RST_MBside: FPC_MB1.12, U3.29 (PB5)
/SCK: FPC_MB1.8, J2.3, U3.9 (PB1)
/SCL: R6.2, U2.14 (SCL), U3.18 (PD0), U5.13 (B1)
/SDA: R7.2, U2.15 (SDA), U3.19 (PD1), U5.12 (B2)
/SW1_MBside: FPC_MB1.1, R10.1, U2.4 (P0)
/SW2_MBside: FPC_MB1.2, R11.1, U2.5 (P1)
/SW3_MBside: FPC_MB1.3, R12.1, U2.6 (P2)
/SW4_MBside: FPC_MB1.4, R13.1, U2.7 (P3)
/SW5_MBside: FPC_MB1.5, R14.1, U2.9 (P4)
GND: C2.2, C4.2, C6.1, C7.1, C8.1, C9.1, C10.1, C11.1, C12.1, C13.1, C14.1, C15.1, C16.2, C17.2, C18.2, C19.2, C20.1, C21.1, C22.1, D1.2 (A), DC1.2, DC1.3, FPC_MB1.7, FPC_MB1.13, FPC_MB1.14, H1.1 (1_1), H1#2.1 (1_1), H1#3.1 (1_1), H2.1 (1_1), J2.6, J3.A1_B12 (GND), J3.B1_A12 (GND), J3.SH1 (SHELL_GND), J3.SH2 (SHELL_GND), J3.SH3 (SHELL_GND), J3.SH4 (SHELL_GND), J4.2, J5.3, LED1.2 (K), R4.2, R10.2, R11.2, R12.2, R13.2, R14.2, R15.2, R16.2, RST1.1, TP9.1 (1_1), U1.6 (GND), U1.9 (GNDPAD), U2.1 (A0), U2.2 (A1), U2.3 (A2), U2.8 (GND), U3.5 (UGND), U3.15 (GND), U3.23 (GND), U3.33 (~HWB/PE2), U3.35 (GND), U3.43 (GND), U4.1 (GND), U5.7 (GND), U6.2 (AVSSVCSEL), U6.3 (GND), U6.4 (GND2), U6.6 (GND3), U6.12 (GND4), U7.5 (GND), Y1.2 (G), Y1.3 (G)
unnamed: C1.1, D1.1 (K), L1.1, U1.8 (PH)
unnamed: J3.A5 (CC1), R16.1
unnamed: J3.B5 (CC2), R15.1
unnamed: J3.A7 (DN1), J3.B7 (DN2), R9.1
unnamed: J3.A6 (DP1), J3.B6 (DP2), R8.1
unnamed: J4.1, U7.3 (IP-), U7.4 (IP-)
unnamed: JP1.2 (B), R1.1
unnamed: LED1.1 (A), R2.2
unnamed: R1.2, R2.1
unnamed: C1.2, U1.1 (BOOT)
unnamed: R3.2, R4.1, U1.4 (VSENSE)
unnamed: C12.2, U3.42 (AREF)
unnamed: C13.2, U3.6 (UCAP)
unnamed: C8.2, U3.17 (XTAL1), Y1.4
unnamed: C9.2, U3.16 (XTAL2), Y1.1
unnamed: R17.2, TP15.1 (1_1), U5.2 (A1), U6.10 (SCL)
unnamed: R18.2, TP16.1 (1_1), U5.3 (A2), U6.9 (SDA)
unnamed: R20.2, TP17.1 (1_1), U5.4 (A3), U6.7 (GPIO1)
unnamed: R19.2, TP18.1 (1_1), U6.5 (XSHUT)
unnamed: R21.1, U7.7 (VOUT)
unnamed: C21.2, U7.6 (VREF)
VBUS: J3.A4_B9 (VBUS), J3.B4_A9 (VBUS), U3.7 (VBUS)
