Diabltica/Desktopia/hardware/desktopia_HMI.kicad_pcb

## KiCad design hardware/desktopia_HMI.kicad_pcb (2026-09-05)

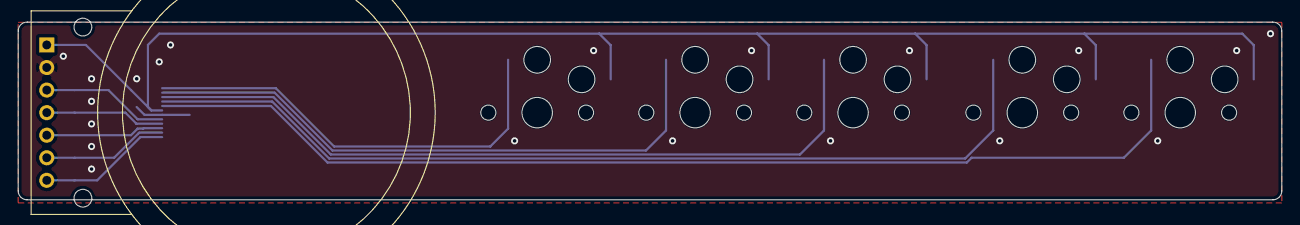
[picture p69: board hardware/desktopia_HMI.kicad_pcb from above]

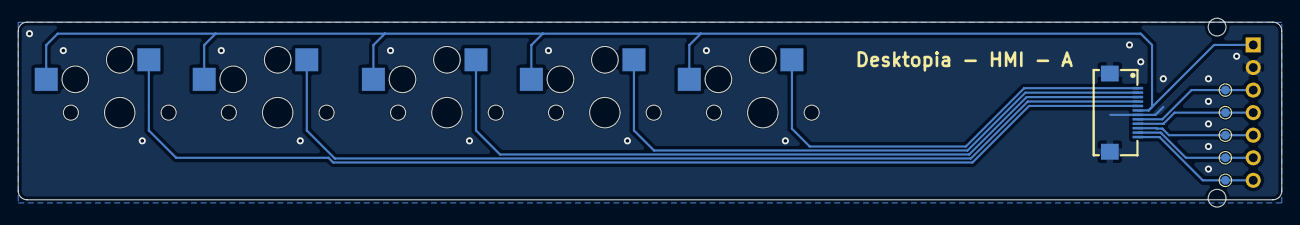
[picture p70: board hardware/desktopia_HMI.kicad_pcb from below]

Board: 2 copper layers, 142.2 x 21.3 mm, 12 parts (6 on the bottom side), 12 nets.

Parts:
FPC_HMI1: F2D12U-A1G1-ER
J1: LCD_Connector; LCD_round_screen
SW1, SW2, SW3, SW4, SW5: SW_Push; PG1350
TP2, TP3, TP4, TP5, TP6: TestPoint; TestPoint_Pad_D1.0mm

Connections:
+5VA: FPC_HMI1.6, J1.1, SW1.2, SW2.2, SW3.2, SW4.2, SW5.2
/CS_HMIside: FPC_HMI1.11, J1.6, TP5.1 (1_1)
/DC_HMIside: FPC_HMI1.10, J1.5, TP4.1 (1_1)
/MOSI_HMIside: FPC_HMI1.9, J1.4, TP3.1 (1_1)
/RST_HMIside: FPC_HMI1.12, J1.7, TP6.1 (1_1)
/SCK_HMIside: FPC_HMI1.8, J1.3, TP2.1 (1_1)
/SW1_HMIside: FPC_HMI1.1, SW1.1
/SW2_HMIside: FPC_HMI1.2, SW2.1
/SW3_HMIside: FPC_HMI1.3, SW3.1
/SW4_HMIside: FPC_HMI1.4, SW4.1
/SW5_HMIside: FPC_HMI1.5, SW5.1
GNDA: FPC_HMI1.7, FPC_HMI1.13, FPC_HMI1.14, J1.2
