Diabltica/Desktopia/hmi_firmware/src/gc9a01.cpp

#include "gc9a01.h"
#include "hmi_config.h"
#include "hmi_pins.h"
#include <SPI.h>

namespace {

constexpr uint8_t CMD_CASET = 0x2A;
constexpr uint8_t CMD_RASET = 0x2B;
constexpr uint8_t CMD_RAMWR = 0x2C;
constexpr uint8_t CMD_MADCTL = 0x36;

// MADCTL for rotation 0..3 (MX / MV / MY bits + BGR order), as in Adafruit_GC9A01A::setRotation()
const uint8_t kMadctl[4] = {0x48, 0x28, 0x88, 0xE8};

// Command list: {command, argCount | 0x80 if a 150 ms pause follows, args...}, terminated by 0.
// Generated from Adafruit_GC9A01A's initcmd[].
const uint8_t kInit[] = {
  0xEF, 0x00,
  0xEB, 0x01, 0x14,
  0xFE, 0x00,
  0xEF, 0x00,
  0xEB, 0x01, 0x14,
  0x84, 0x01, 0x40,
  0x85, 0x01, 0xFF,
  0x86, 0x01, 0xFF,
  0x87, 0x01, 0xFF,
  0x88, 0x01, 0x0A,
  0x89, 0x01, 0x21,
  0x8A, 0x01, 0x00,
  0x8B, 0x01, 0x80,
  0x8C, 0x01, 0x01,
  0x8D, 0x01, 0x01,
  0x8E, 0x01, 0xFF,
  0x8F, 0x01, 0xFF,
  0xB6, 0x02, 0x00, 0x00,
  0x36, 0x01, 0x48,
  0x3A, 0x01, 0x05,
  0x90, 0x04, 0x08, 0x08, 0x08, 0x08,
  0xBD, 0x01, 0x06,
  0xBC, 0x01, 0x00,
  0xFF, 0x03, 0x60, 0x01, 0x04,
  0xC3, 0x01, 0x13,
  0xC4, 0x01, 0x13,
  0xC9, 0x01, 0x22,
  0xBE, 0x01, 0x11,
  0xE1, 0x02, 0x10, 0x0E,
  0xDF, 0x03, 0x21, 0x0C, 0x02,
  0xF0, 0x06, 0x45, 0x09, 0x08, 0x08, 0x26, 0x2A,
  0xF1, 0x06, 0x43, 0x70, 0x72, 0x36, 0x37, 0x6F,
  0xF2, 0x06, 0x45, 0x09, 0x08, 0x08, 0x26, 0x2A,
  0xF3, 0x06, 0x43, 0x70, 0x72, 0x36, 0x37, 0x6F,
  0xED, 0x02, 0x1B, 0x0B,
  0xAE, 0x01, 0x77,
  0xCD, 0x01, 0x63,
  0xE8, 0x01, 0x34,
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
  0x04, 0x04, 0x3F, 0x44, 0x24, 0x3C, 0x40, 0x40, 0x20, 0x7C, 0x1C, 0x20, 0x40, 0x20, 0x1C, 0x3C, 0x40, 0x30, 0x40, 0x3C,
  0x44, 0x28, 0x10, 0x28, 0x44, 0x4C, 0x90, 0x90, 0x90, 0x7C, 0x44, 0x64, 0x54, 0x4C, 0x44, 0x00, 0x08, 0x36, 0x41, 0x00,
  0x00, 0x00, 0x77, 0x00, 0x00, 0x00, 0x41, 0x36, 0x08, 0x00, 0x02, 0x01, 0x02, 0x04, 0x02,
};

inline void spiSend(uint8_t b) { SPI.transfer(b); }

inline void spiSendBuf(const uint8_t* buf, size_t n) { SPI.transfer(buf, nullptr, n); }

inline void spiSend16(uint16_t v) {
  spiSend((uint8_t)(v >> 8));
  spiSend((uint8_t)v);
}

inline void csLow() { digitalWrite(hmipins::LCD_CS, LOW); }
inline void csHigh() { digitalWrite(hmipins::LCD_CS, HIGH); }
inline void dcCommand() { digitalWrite(hmipins::LCD_DC, LOW); }
inline void dcData() { digitalWrite(hmipins::LCD_DC, HIGH); }

uint16_t isqrt(uint32_t n) {                       // floor(sqrt(n))
  uint32_t root = 0;
  uint32_t bit = 1UL << 30;
  while (bit > n) bit >>= 2;
  while (bit) {
    if (n >= root + bit) {
      n -= root + bit;
      root = (root >> 1) + bit;
    } else {
      root >>= 1;
    }
    bit >>= 2;
  }
  return (uint16_t)root;
}

}  // namespace

void Gc9a01::sendCommand(uint8_t cmd, const uint8_t* args, uint8_t count) {
  csLow();
  dcCommand();
  spiSend(cmd);
  dcData();
  if (count) spiSendBuf(args, count);
  csHigh();
}

void Gc9a01::begin(uint8_t rotation) {
  pinMode(hmipins::LCD_CS, OUTPUT);
  csHigh();
  pinMode(hmipins::LCD_DC, OUTPUT);
  dcData();
  SPI.setSCK(hmipins::LCD_SCK);
  SPI.setTX(hmipins::LCD_MOSI);
  SPI.begin();
  SPI.beginTransaction(SPISettings(DISPLAY_SPI_HZ, MSBFIRST, SPI_MODE0));   // kept open: the LCD is the only SPI device

  pinMode(hmipins::LCD_RST, OUTPUT);               // hardware reset, same timing as the Adafruit library
  digitalWrite(hmipins::LCD_RST, HIGH);
  delay(100);
  digitalWrite(hmipins::LCD_RST, LOW);
  delay(100);
  digitalWrite(hmipins::LCD_RST, HIGH);
  delay(200);

  const uint8_t* p = kInit;
  uint8_t cmd;
  while ((cmd = *p++) != 0) {
    uint8_t flags = *p++;
    uint8_t n = flags & 0x7F;
    sendCommand(cmd, p, n);
    p += n;
    if (flags & 0x80) delay(150);
  }

  uint8_t madctl = kMadctl[rotation & 3];
  csLow();
  dcCommand();
  spiSend(CMD_MADCTL);
  dcData();
  spiSend(madctl);
  csHigh();
}

void Gc9a01::openWindow(int16_t x0, int16_t y0, int16_t x1, int16_t y1) {
  csLow();
  dcCommand();
  spiSend(CMD_CASET);
  dcData();
  spiSend16((uint16_t)x0);
  spiSend16((uint16_t)x1);
  dcCommand();
  spiSend(CMD_RASET);
  dcData();
  spiSend16((uint16_t)y0);
  spiSend16((uint16_t)y1);
  dcCommand();
  spiSend(CMD_RAMWR);
  dcData();
}

void Gc9a01::closeWindow() { csHigh(); }

void Gc9a01::streamColor(uint16_t color, uint32_t count) {
  uint8_t buf[128];                                // 64 pixels per SPI block transfer
  for (uint8_t i = 0; i < sizeof(buf); i += 2) {
    buf[i] = (uint8_t)(color >> 8);
    buf[i + 1] = (uint8_t)color;
  }
  while (count) {
    uint32_t n = count > sizeof(buf) / 2 ? sizeof(buf) / 2 : count;
    spiSendBuf(buf, n * 2);
    count -= n;
  }
}

void Gc9a01::fillRect(int16_t x, int16_t y, int16_t w, int16_t h, uint16_t color) {
  if (w <= 0 || h <= 0) return;
  if (x < 0) { w = (int16_t)(w + x); x = 0; }
  if (y < 0) { h = (int16_t)(h + y); y = 0; }
  if (x >= kSize || y >= kSize) return;
  if (x + w > kSize) w = (int16_t)(kSize - x);
  if (y + h > kSize) h = (int16_t)(kSize - y);
  if (w <= 0 || h <= 0) return;
  openWindow(x, y, (int16_t)(x + w - 1), (int16_t)(y + h - 1));
  streamColor(color, (uint32_t)w * (uint32_t)h);
  closeWindow();
}

void Gc9a01::fillCircle(int16_t cx, int16_t cy, int16_t r, uint16_t color) {
  for (int16_t dy = -r; dy <= r; dy++) {
    int16_t dx = (int16_t)isqrt((uint32_t)((int32_t)r * r - (int32_t)dy * dy));
    fillRect((int16_t)(cx - dx), (int16_t)(cy + dy), (int16_t)(2 * dx + 1), 1, color);
  }
}

void Gc9a01::drawScaledRun(int16_t x, int16_t y, const uint16_t* colors, uint8_t count, uint8_t scale) {
  int16_t w = (int16_t)(count * scale);
  if (!count || !scale || x < 0 || y < 0 || x + w > kSize || y + scale > kSize) return;
  uint8_t line[kSize * 2];                         // one screen row of the run
  uint16_t n = 0;
  for (uint8_t i = 0; i < count; i++) {
    for (uint8_t k = 0; k < scale; k++) {
      line[n++] = (uint8_t)(colors[i] >> 8);
      line[n++] = (uint8_t)colors[i];
    }
  }
  openWindow(x, y, (int16_t)(x + w - 1), (int16_t)(y + scale - 1));
  for (uint8_t r = 0; r < scale; r++) spiSendBuf(line, n);
  closeWindow();
}

void Gc9a01::drawChar(int16_t x, int16_t y, char c, uint8_t scale, uint16_t fg, uint16_t bg) {
  if (scale == 0) return;
  if (c < 32 || c > 126) c = '?';
  int16_t w = (int16_t)(6 * scale);
  int16_t h = (int16_t)(8 * scale);
  if (x < 0 || y < 0 || x + w > kSize || y + h > kSize) return;

  uint8_t col[5];
  const uint8_t* glyph = kFont + (uint16_t)(c - 32) * 5;
  for (uint8_t i = 0; i < 5; i++) col[i] = glyph[i];

  uint8_t fh = (uint8_t)(fg >> 8), fl = (uint8_t)fg, bh = (uint8_t)(bg >> 8), bl = (uint8_t)bg;
  uint8_t line[6 * 2 * 16];                        // one pixel row of the glyph, scale <= 16
  if (scale > 16) return;
  openWindow(x, y, (int16_t)(x + w - 1), (int16_t)(y + h - 1));
  for (uint8_t row = 0; row < 8; row++) {
    uint16_t n = 0;
    for (uint8_t cx = 0; cx < 6; cx++) {
      bool on = cx < 5 && row < 7 && ((col[cx] >> row) & 1);
      uint8_t hi = on ? fh : bh;
      uint8_t lo = on ? fl : bl;
      for (uint8_t rx = 0; rx < scale; rx++) {
        line[n++] = hi;
        line[n++] = lo;
      }
    }
    for (uint8_t ry = 0; ry < scale; ry++) spiSendBuf(line, n);
  }
  closeWindow();
}

void Gc9a01::drawText(int16_t x, int16_t y, const char* text, uint8_t scale, uint16_t fg, uint16_t bg) {
  for (; *text; text++) {
    drawChar(x, y, *text, scale, fg, bg);
    x = (int16_t)(x + 6 * scale);
  }
}
