Diabltica/Desktopia/(commit log)

2023-09-25 create kicad project
    [desktopia.kicad_pcb, desktopia.kicad_sch, laser-meter.kicad_sch, motor-driver.kicad_sch]
2026-08-25 schematic done, PCB first wip
    [SOP-8_L4.9-W3.9-P1.27-LS6.0-BL-1.step, desktopia.kicad_pcb, desktopia.kicad_sch, desktopia_HMI.kicad_pcb, laser-meter.kicad_sch, motor-driver.kicad_sch]
2026-09-05 finish pcb
    [desktopia-B_Cu.gbl, desktopia-B_Mask.gbs, desktopia-B_Paste.gbp, desktopia-B_Silkscreen.gbo, desktopia-Edge_Cuts.gm1, desktopia-F_Cu.gtl, desktopia-F_Mask.gts, desktopia-F_Paste.gtp]
2026-09-05 clean repo
    [SOP-8_L4.9-W3.9-P1.27-LS6.0-BL-1.step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]
2026-10-18 HMI board with its own RP2040, linked to the motherboard by RS-485 over an RJ11 cord
    - motherboard firmware: HMI link master (Serial1 + DE on PD4), TCA9554 and screen driver removed,
    Up+Down stop of a preset move, motor stopped when the link is lost
    - hmi_firmware: RP2040 (arduino-pico), link slave with A/B polarity detection, screen on core 1
    - shared/hmi_link: frame protocol (CRC-16) and screen model used by both firmwares
    - simulation of both boards over a simulated RS-485 bus (628 checks)
    - schematics: RJ11 + THVD1450 on the motherboard, new desktopia_HMI.kicad_sch
2026-10-19 hardware: one folder per KiCad project
    - hardware/desktopia/ (motherboard) and hardware/desktopia_HMI/ (HMI board), each with its own sym-lib-table /
    fp-lib-table pointing at the shared hardware/kicad_library/
    - USB4105GFA symbol library added to the tables (it was referenced but not declared)
    - JLCImport 3D model paths fixed to ${KIPRJMOD}/../kicad_library/pcb/JLCImport.3dshapes/ in both boards and in the
    library footprints (12 of them pointed to a folder that does not exist)
2026-10-19 hardware: JLCPCB part numbers, safe TPS5430 enable, 24 V screw terminal, INA226 current sensor
    - Every assembled part gets LCSC / jlcpcb PartNumber fields, Basic parts first (SP485EEN, SP3485EN,
    W25Q128JV, 12 MHz crystal with 33 pF, TS-1088 buttons, ...).
    - TPS5430 ENA was tied to the 24 V input (7 V absolute maximum) and burnt the regulator: left open now.
    - C25 10 uF 50 V ceramic input capacitor next to C2.
    - 1.5 A barrel jack DC1 replaced by the 5.08 mm screw terminal J7.
    - Analog CC6905 replaced by a 2 mOhm shunt + INA226 on I2C (0x40), alert on PE6; PF0 is free.
2026-10-19 docs: project README and one README per board
    The hardware notes move from the firmware README to the motherboard and HMI board READMEs.
2026-10-19 ci: render the schematic, PCB and 3D images of the hardware READMEs on every push
2026-10-19 hardware: realistic 3D model of the round LCD module
    RoundLCD.wrl replaces RoundLCD.step in the footprint (the .step stays for STEP export with --subst-models):
    blue module PCB, panel frame, black bezel, glass, flex cable, header, back-side parts, and the real UI on
    the screen, made of self-lit quads from a simulator screenshot (KiCad cannot texture 3D models).
    Generated by kicad_library/pcb/tools/round_lcd_3d.py.
2026-10-20 hardware: HMI cord soldered to the board instead of an RJ11 jack
    The HMI board sits at 45 deg under the desk edge: a jack would stand 12 mm off the board and send the
    cord off at 45 deg to the desk. J2 is now Desktopia:Cable_6P6C_SolderPads (6 pads at 2.54 mm, cable-tie
    strain relief, board-edge mark), generated by kicad_library/pcb/tools/cable_6p6c_fp.py. The RJ11 plug
    stays on the motherboard end. Also includes the reorganised HMI schematic layout.
2026-10-20 hardware: JLCPCB cost pass, motor input with margin, BSS138 level shifters
    Motherboard:
    - Extended part numbers 12 -> 9: TXS0104E -> BSS138 level shifters (Preferred),
    C4 electrolytic -> 2 x 47 uF ceramic with the TI SLVA237 compensation,
    J5 -> the same KF128 terminal as J4 / J7, J3 GCT USB4105 (out of stock)
    -> G-Switch GT-USB-7010ASV, R1 + R2 -> R1, F1 -> 30 V PTC.
    - 24 V input with margin: SMBJ28A TVS, 220 uF 50 V bulk, 24 A terminals.
    5 V rail good for 1.5 A: 22 uH 1.8 A inductor, SS34.
    - Sensor rail stays at 2.8 V (VL53L1CB typical, 0.7 V under its maximum).
    VL53L1CB GPIO1 -> TOF_INT on PB4 (PCINT4) through a third BSS138.
    - 10k pull-downs on Mpwm / Mdir. INA226 alert kept on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
2026-10-22 hardware: motor supply switch, schematics redrawn with fewer labels, re-annotation
    - Q5 P-MOSFET high-side switch on the driver supply (Q4 gate driver, D3 clamp,
    C21 soft start, R22 pull-down), driven by PD7 (MOTOR_PWR); TP13 on MOTOR_SW
    - Schematic redrawn: wires instead of labels inside each block (76 -> 22 labels),
    same netlist
    - J6 motor command terminal: 3 pins again (ZX-DG28L-2.54-3P), pin 3 = driver logic GND
    - C6 24 V bulk: 220 uF 10 x 10 mm -> 100 uF 8 x 10 mm (C970687), same cable damping
    - Re-annotated; TP9 on TOF_INT, H3 mounting hole, J3 and Y1 symbols updated,
    HWB left open; notes and README follow the new references
    HMI board:
    - Schematic redrawn without la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
2026-10-22 firmware: cut the motor driver supply on a current alert and after 5 min idle
    - current_monitor: INA226 setup and alert threshold; the INT6 handler cuts the PWM
    and opens Q5 at once, without waiting for the loop
    - motor: driver supply on before a move (100 ms settle), off after 5 minutes idle,
    only with the PWM at 0; a cut latch keeps the loop from undoing an interrupt cut
    - controller: Overcurrent and CurrentSense faults, no move without the INA226
    (CURRENT_MONITOR_REQUIRED), current log in the debug build
    - HMI texts for both faults
    - Simulator: INA226 and supply switch models, tests including the cut latch
    - Comments and README follow the re-annotated schematic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
2026-10-27 hardware: motherboard PCB updated from the schematic, LCSC 3D models for the connectors
    Footprints synced with the re-annotated schematic and given their 3D models. J3 and J4 use the LCSC models (VRML), U2 uses KiCad's TI_SO-PowerPAD-8. README: the J4 RJ11 jack fits its footprint, check the drilling against the datasheet.
2026-10-27 hardware: HMI board re-annotated, PCB updated from the RP2040 schematic
    The PCB now holds the RP2040 design (references included); the routing is not finished. README tables, connector pin-outs, test points and assembly notes follow the new references.
2026-10-27 firmware: follow the HMI board re-annotation in pin comments and READMEs
    Buttons are now SW2-SW6, BOOT is SW1, the LCD is J2, the cord J3, the transceiver U4, and SWD is on TP1-TP4. No pin assignment changes.
2026-11-02 firmware: animated pixel-art screens on the HMI board
    The HMI board draws the new screen design: a 60 x 60 frame of 4 x 4 blocks
    (canvas.cpp) that only sends the blocks that changed, and the scenes of
    scene.cpp, with the sprites, palette and timings of the design GIFs:
    - Up / Down: chevrons and bubbles in the height ring, driven by the measured
    travel (they start with the soft start and stop with the desk)
    - long press: floppy, 24-segment gauge, white flash, SAVED with sparkles
    - automatic move: flag with the target height, dotted travel left, gold
    "ding" on arrival
    - at rest: the ring shows the height between HEIGHT_MIN_MM and HEIGHT_MAX_MM
    with a mark per preset, 1-2-3 pills under th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
2026-11-02 git: ignore the KiCad local history and the editor settings
    KiCad 10 keeps a local history in a .history git repository inside each
    project folder (25 MB here); .vscode/ holds paths of the local machine.
2026-11-02 hardware: HMI board laid out and routed, Kelvin footprint for the motor shunt
    HMI board: 139.7 x 33.3 mm outline, parts placed and routed (358 tracks,
    47 vias), M2 mounting holes H1 / H2, screen module J2 turned 180° (pin
    header towards the buttons).
    Motherboard: R23 (2 mOhm, 3 W) becomes a 4-terminal current-sense resistor,
    R_Shunt symbol and R_2512_CurrentSensing_opti footprint; placement updated.
    On both PCBs the test point footprints were removed, but the test points are
    still in the schematics (only TP5 is left on the motherboard).
    Motherboard README images rendered with KiCad 10.0.5.
2026-11-02 hmi: screen module turned 180°, display rotation and 3D model with the new UI
    The round screen module now sits with its pin header towards the buttons
    (J2 at 90° on the HMI board): DISPLAY_ROTATION 1 -> 3 keeps the picture
    upright.
    RoundLCD.wrl regenerated from a simulator screenshot of the pixel-art UI:
    picture turned to match the module (SCREEN_ROT 270), active area lit in the
    UI's navy background (the old generator only kept bright pixels), identical
    runs of pixels merged into rectangles (337 kB). HMI README images rendered
    with KiCad 10.0.5.
2026-11-02 hardware: 3D model of the cord soldered to J3 on the HMI board
    Cable_6P6C_SolderPads.wrl, generated by cable_6p6c_3d.py and attached to
    the J3 footprint (library, footprint generator and HMI PCB): the flat 6P6C
    cord lies against the bottom of the board and runs about 1 cm past the
    edge, its six wires fan out to the holes and are soldered on the top, and a
    black 2.5 mm cable tie goes around the jacket and through both slots, its
    head under the cord. README: the cord goes on the bottom of the board.
    The VRML helpers move to tools/vrml.py, shared with round_lcd_3d.py, whose
    output is now the same on every run (same RoundLCD model, rectangles in a
    fixed order). README images: rendered by the CI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
2026-11-02 mechanical: slide-in motor supports with TPU silent blocks, and the jaw coupling
    - CadQuery scripts in source/ generate every part, figure and the 18-page assembly report
    - STL ready to slice (full print plates *_x2 / *_x4 / *_x8), STEP models, check assemblies and the DXF profile
    of the clip (sample 4)
    - BOM.md: printed parts with print settings, screws and inserts, bought coupler, reused parts, tools
    - original SolidWorks drill adapter kept in solidworks/
    - row in the repository layout of the project README
2026-11-02 firmware: one folder per PlatformIO project, like the hardware
    - firmware/desktopia/ (motherboard) and firmware/desktopia_HMI/ (HMI board, was hmi_firmware/), each with its README
    - the link protocol moves to firmware/shared/hmi_link/: lib_extra_dirs = ../shared is unchanged in both projects
    - the PC simulation of both boards (sim/) and its pictures (docs/) stay at the firmware/ level; .gitignore split
    between each project and the simulation
    - paths updated in the source comments, sim/run.sh, the READMEs and the note in the HMI schematic
    Both projects build with the same sizes as before; the simulation passes its 912 checks.
2026-11-03 mechanical: drill adapter and hub A merged into one printed part, the drill hub
    - solidworks/: DrillAdapter+hub.SLDASM (drillAdapterV4.SLDPRT + hub_a_drill_side.SLDPRT, imported
    from step/hub_a_drill_side.step) and DrillAdapter+hub.STL to print
    - removed: the previous drill adapter (V3) and the STL of hub A alone; build_coupling.py now exports
    hub A as STEP only
    - BOM: drill hub instead of hub A + adapter, so 4 M3 x 8 screws and 4 inserts less; README updated
    (the report still shows the screwed version)
2026-11-08 mechanical: drilling jig, insert bosses on the ring pads, report updated for the drill hub
    - drilling jig (source/build_drill_jig.py, step/ and stl/drill_jig): light frame with the 4 drill guides
    and 2 lips against the vertical wood face, rows AXIAL_SPACING = 58.0 apart (RING_GAP 44.5 measured
    between the rings + half widths); README section and report page
    - ring supports: a boss dia 8 x 1 around each insert of the pad (dia 3.8 x 4.5 pocket); the clip plates
    get a dia 8.4 x 1.1 recess over each boss, which also centres them
    - the 8 heat-set inserts are now all M3 x 4 x OD4.2 (dia 3.8 pockets, hub B included)
    - coupling: hub A without screws or counterbores (it is the jaw end of the dr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
2026-11-08 clean up: drop redundant meshes and orphan 3D models
    mechanical/stl keeps only the meshes to slice, step/ keeps one model of every part:
    - clip_plate, plot, cushion_wheel: already in the print layouts clip_plates_x2, plots_x4, cushions_x8
    (to print one alone, split the layout into objects in the slicer)
    - ring_support_*_desk_frame: CAD frame, the STEP is the CAD file; the _print STL is the one to slice
    - clip_cut_tool: a cutting tool for SolidWorks, the STEP and the DXF are what is used
    - build_slide_mount.py exports these as STEP only now (export(..., stl=False)); BOM and README updated
    hardware/kicad_library: 3D models that no footprint and no board references
    - EASYEDA_MODELS/SOP-8_L4.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
2026-11-11 hardware: DRV8701E symbol and pluggable terminal blocks with their plugs in 3D
    - kicad_library/sch/Desktopia.kicad_sym: hand-made DRV8701ERGER symbol (TI SLVSCX5B pin table, PH/EN variant)
    - Desktopia.pretty/PluggableHeader_*: KiCad's Phoenix Contact header footprints (MSTBA 5.08, GMSTBA 7.62,
    MC 3.81: the Kefa KF2EDGRC and KANGNEX 15EDGRC headers copy them) with two 3D models, the header and its
    mated plug, and the plug outline on F.Fab
    - Desktopia.3dshapes/Plug_*.wrl: the plugs (Kefa KF2EDGK 5.08 / 7.62, KANGNEX 15EDGK 3.81) from Phoenix
    Contact's figures, mated in the cavity measured on KiCad's header models
    - tools/pluggable_plug_3d.py and tools/pluggable_header_fp.py build them
    C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
2026-11-11 hardware: on-board H-bridge, pluggable connectors, colours, net classes and DRC rules on the motherboard
    - H-bridge: U7 DRV8701E + Q6-Q9 BSC028N06NS (15 A, PWM up to 100 kHz, 25 kHz planned), C24-C32 bulk and
    decoupling, J7 to the motor. nSLEEP on PB5, nFAULT on PB7. Bypass: cut JP2-JP5 (solder jumpers on PH, EN,
    nSLEEP, nFAULT) and the JP6 wire link (VM), J5 / J6 still feed an external driver
    - current limit, cycle by cycle: R27 + R28 (2 x 2 mOhm, R23's part, Kelvin to SP / SN), VREF from +5V by
    R29 / R30 (10k / 3.3k): about 14.6 A; TP14 on SO. The INA226 still cuts the supply
    - J1 / J5 / J6 / J7: pluggable terminal blocks (Kefa KF2EDGRC 5.08 / 7.62, KANGNEX 15EDGRC 3.81, 15 A / 8 A);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
2026-11-11 hardware: net classes, DRC rules and colours on the HMI board
    - net classes for the PCB: Default and Buses 0.2 mm (the RP2040's 0.4 mm pitch), Power_1V1 / Power_3V3 0.3 mm,
    GND / Power_5V 0.4 mm, all at 0.2 mm clearance (every net at 5 V or less), vias 0.6 / 0.3 mm
    - Board Setup minimums and the new desktopia_HMI.kicad_dru from JLCPCB's capabilities and IPC-2221B, as on
    the motherboard; exceptions for the pads and holes of one footprint and the fine-pitch escapes (U3, J1)
    - schematic: a background and a title colour per block, wires coloured by net class, legend
    - README: PCB rules, and the DRC findings in "what to do before ordering": TP1-TP9 missing from the PCB,
    7 thermal reliefs wi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
2026-11-11 hardware: HMI notes follow the current references
    The schematic notes still used the references from before the re-annotation:
    - BOOT is SW1 (not SW6); the RS-485 termination is R8 (not R1); the cord is soldered to J3 and the
    screen plugs into J2 (the notes had J2 and J1)
    - SWD: TP4 SWCLK, TP3 SWDIO, TP1 GND, TP2 RUN (not TP7 / TP8 / TP10 / TP9)
    - RP2040 decoupling: IOVDD on C4-C7, C9, C11 (C8 / C10 are the crystal capacitors)
    - buttons, from the netlist: SW6 Up (GP11), SW5 Down (GP12), SW4 / SW3 / SW2 presets 1 / 2 / 3 (GP13-GP15);
    the HMI README and the comments of firmware/desktopia_HMI/include/hmi_pins.h said SW2 to SW6 the other
    way round (comments only: the firmware goes by GPIO)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
2026-11-11 docs: drop the architecture drawing, redundant with the README flowchart
